SamyFrancelet/LoRaSnow/README.md

# LoRaSnow
LoRaSnow est un projet de recherche, avec pour but de mesurer la hauteur de neige sur une route, pendant qu'il neige.
