SamyFrancelet/LoRaSnow/0500_Software/readme

This folder contains all the files of the Computer/Raspberry programm
