SamyFrancelet/LoRaSnow/0600_Fab/0701_Board/readme

This folder contains all the file necessary to build the PCB
