SamyFrancelet/LoRaSnow/0600_Fab/0704_Software/readme

Binary / Installer for the computer/raspberry software
