SamyFrancelet/LoRaSnow/0000_Docs/0000_Report/LoRaSnow_report/LoRaSnow.tex

\documentclass[11pt,titlepage]{report}
\usepackage{Preamble}
\addbibresource{ref.bib}

\begin{document}

\begin{titlepage}
	\newgeometry{margin=3cm}
	\centering
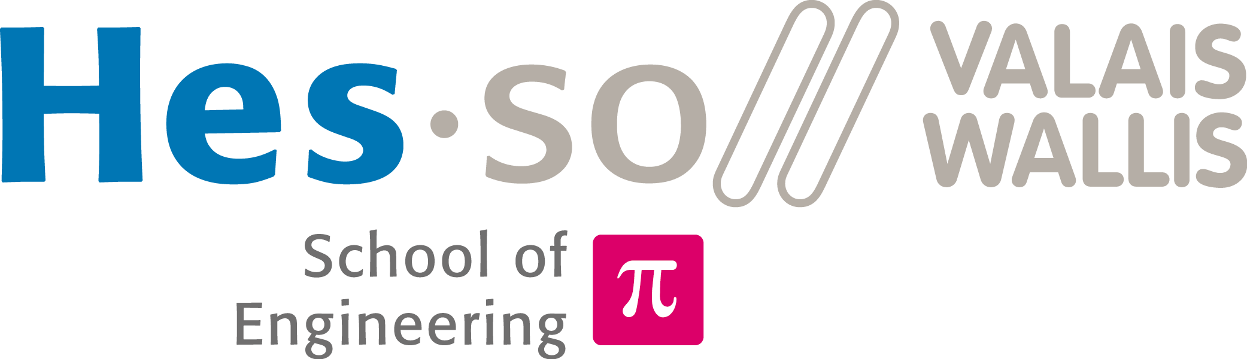
[picture p1: 0000_Docs/0000_Report/business_report/Images/hes/hei.png]
    \\[1cm] 	% University Logo
    \textsc{\LARGE Haute école d'ingénieur du Valais}\\ \vspace{\fill}
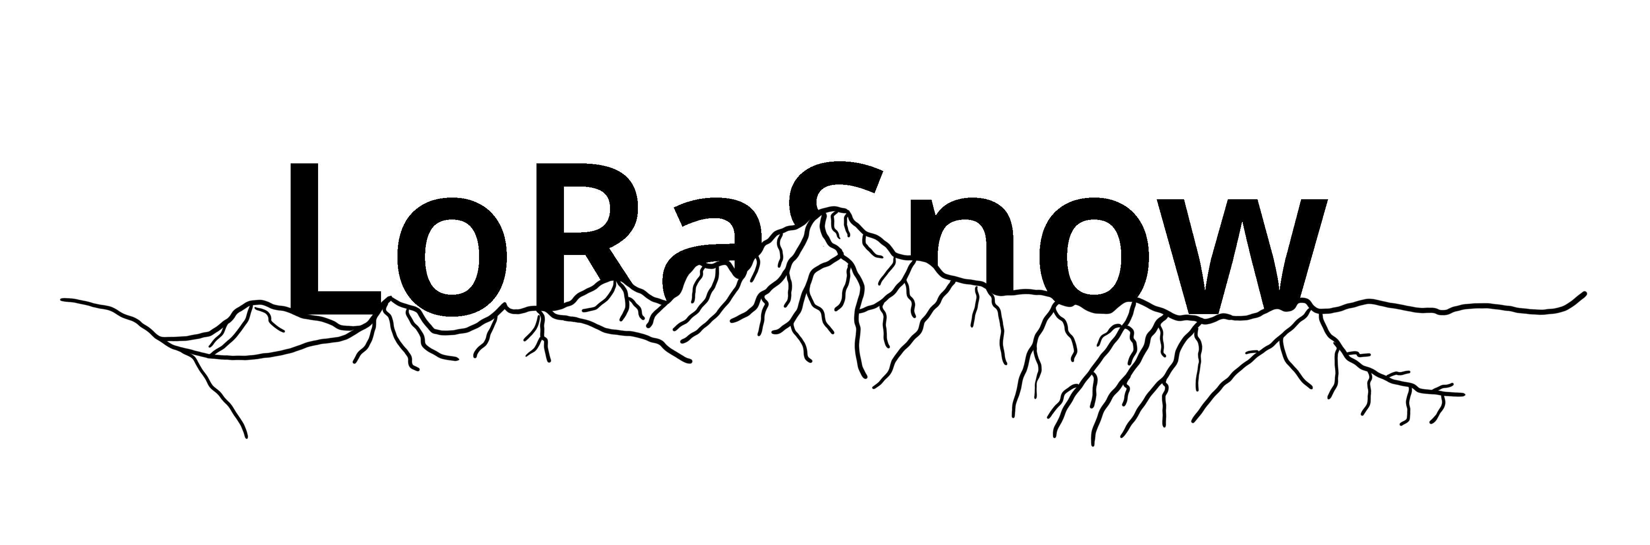
[picture p2: 0000_Docs/0000_Report/LoRaSnow_report/Images/Logo_LoRaSnow.png]
    \\ \vspace{\fill}
	%\textbf{\textsc{\fontsize{35}{35}\selectfont LoRaSnow}}\\ \vspace{\fill}
	\textsc{\LARGE Mesure du niveau de neige en conditions difficiles}\\[0.4cm]
	\rule{\linewidth}{0.2 mm} \\[0.5 cm]
	Samy Francelet, Vincent Savioz, Gabriel Deferr \\
	\today
\end{titlepage}
\restoregeometry

\tableofcontents
\listoffigures
\listoftables
\pagestyle{fancy}

\chapter{Introduction}
\input{1-Introduction.tex}

\part{Technique}

\chapter{Spécifications}
\input{tech/2-Specs.tex}

\chapter{LiDAR}
\input{tech/LiDAR/methods.tex}
\input{tech/LiDAR/results.tex}

\chapter{Computer Vision}
\input{tech/ComputerVision/introduction.tex}
\input{tech/ComputerVision/methods.tex}
\input{tech/ComputerVision/results.tex}

\chapter{Mécanique}
\input{tech/mechanical/methods.tex}

\chapter{Synthèse des résultats}
\input{tech/6-Discussion.tex}

\part{Gestion}

\chapter{Résumé}
\input{business/7-Resume.tex}

\chapter{Produits et services}
\input{business/8-Produits.tex}

\chapter{Marché et Contexte}
\input{business/9-Contexte.tex}

\chapter{Stratégie}
\input{business/10-Strategie.tex}

\chapter{Mesures}
\input{business/11-Mesures.tex}

\chapter{Finances}
\input{business/12-Finances.tex}

\chapter{Conclusion}
\input{13-Conclusion.tex}

\appendix

\chapter{Planning}
\label{app:planning}
\section{Planning prévisionnel}
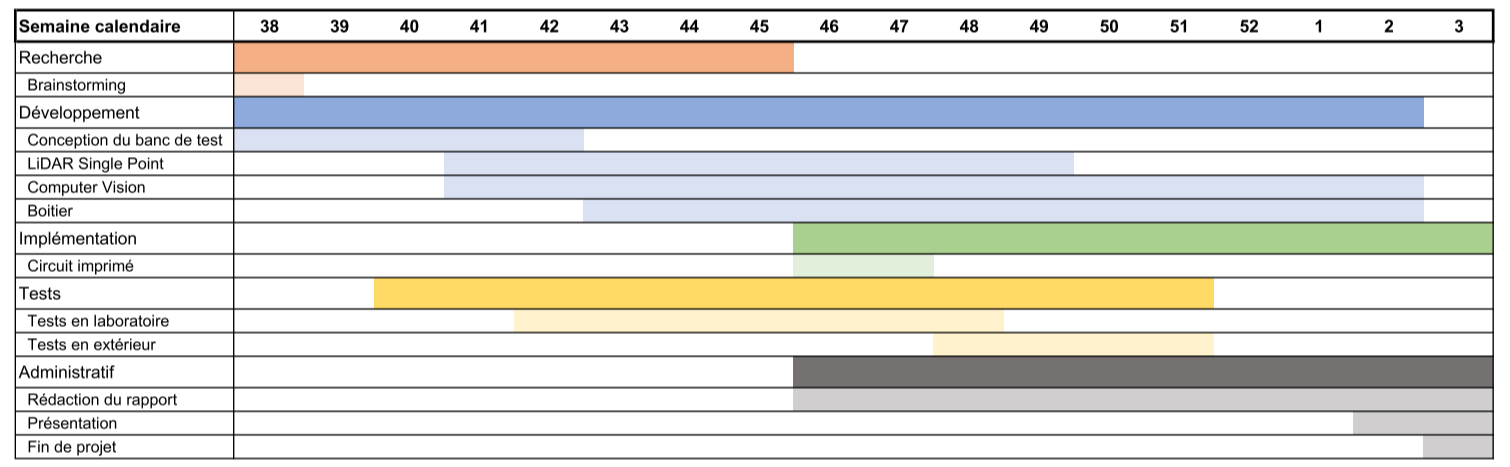
[picture p3: 0000_Docs/0000_Report/LoRaSnow_report/Images/business/planning/prevu.PNG]

\section{Planning réalisé}
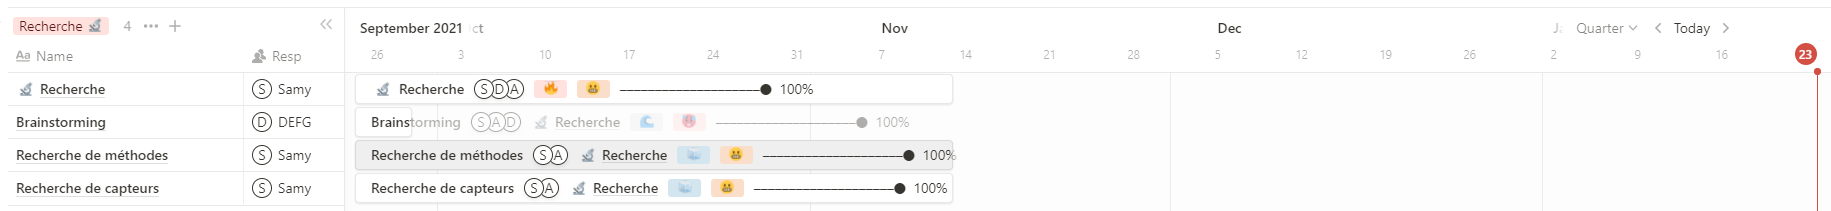
[picture p4: 0000_Docs/0000_Report/LoRaSnow_report/Images/business/planning/research.PNG]

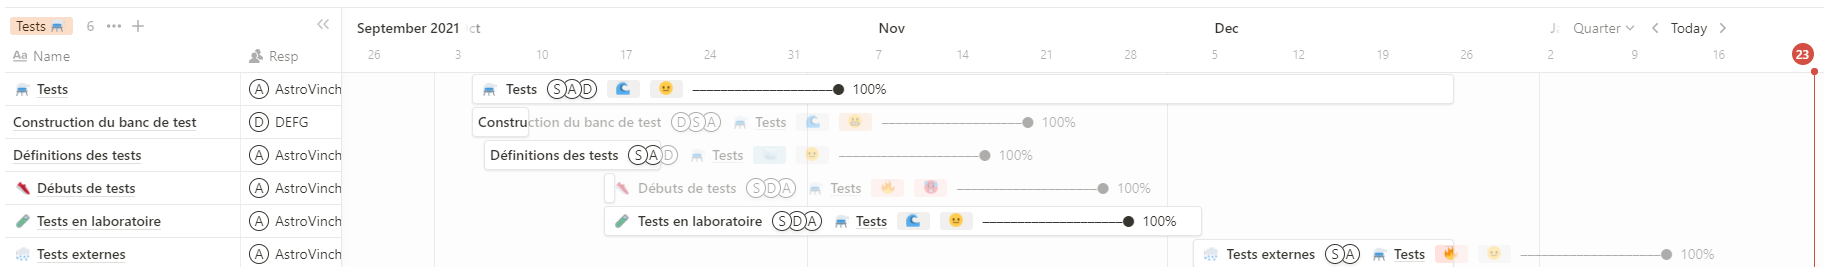
[picture p5: 0000_Docs/0000_Report/LoRaSnow_report/Images/business/planning/tests.PNG]

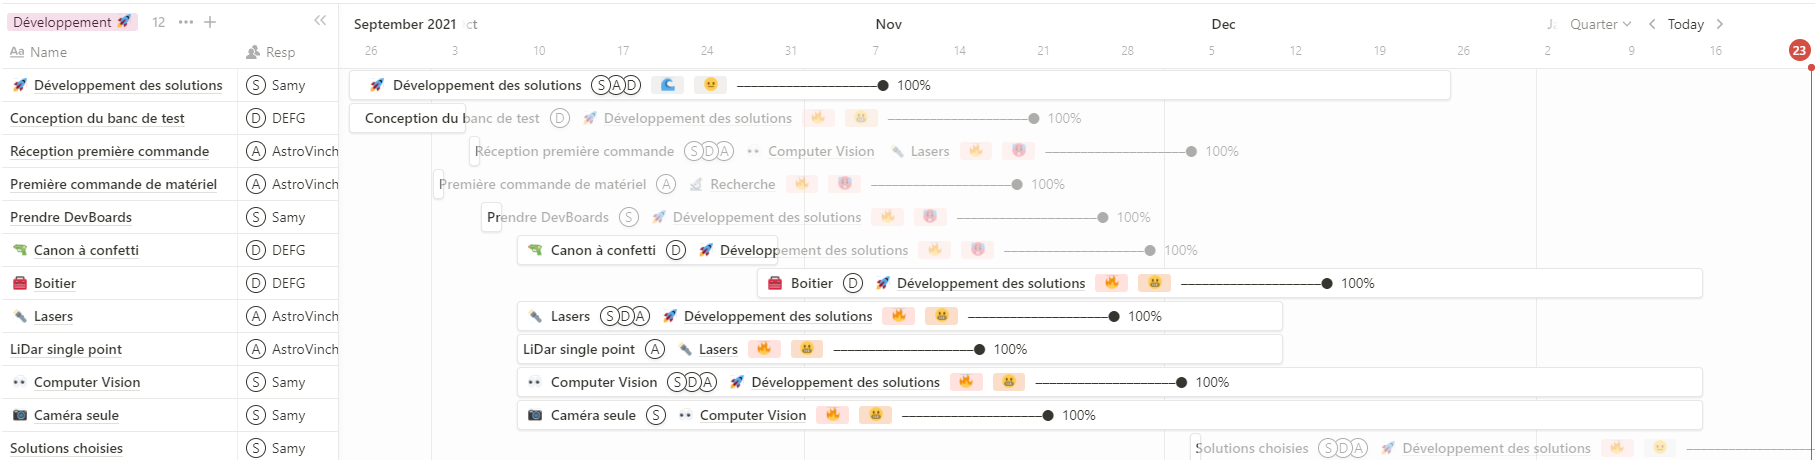
[picture p6: 0000_Docs/0000_Report/LoRaSnow_report/Images/business/planning/dev.PNG]
\newpage
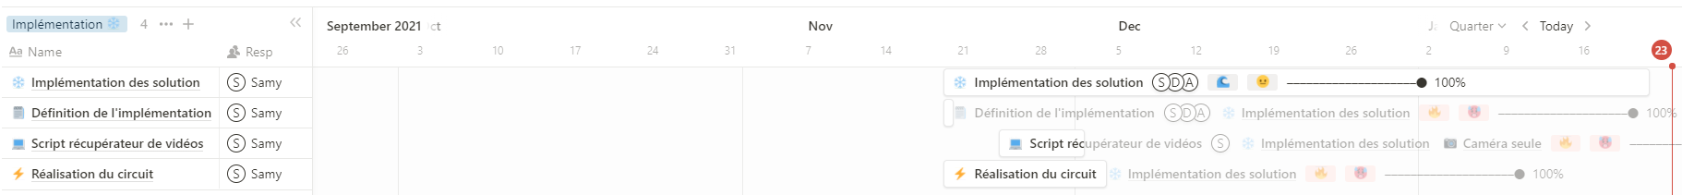
[picture p7: 0000_Docs/0000_Report/LoRaSnow_report/Images/business/planning/implementation.PNG]

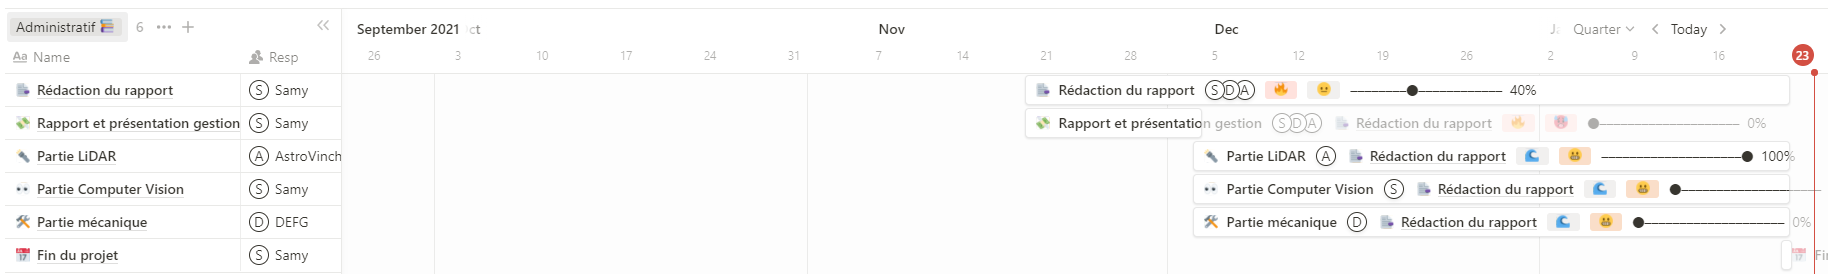
[picture p8: 0000_Docs/0000_Report/LoRaSnow_report/Images/business/planning/admin.PNG]


\chapter{Bilan prévisionnel}
\label{app:bilan}
\section{Prix et coûts}
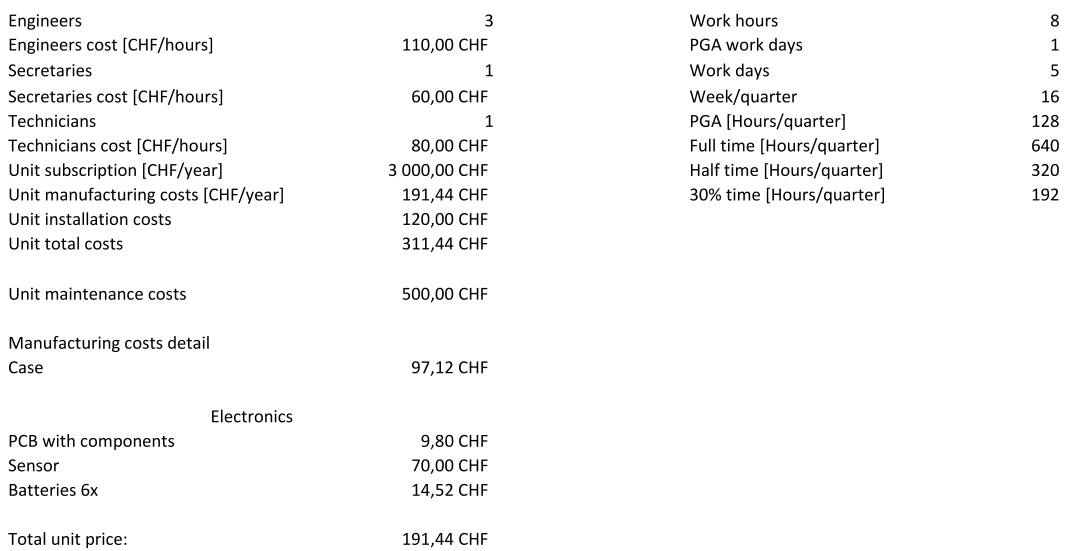
[picture p9: 0000_Docs/0000_Report/LoRaSnow_report/Images/business/costs.png]
 \\[1cm]
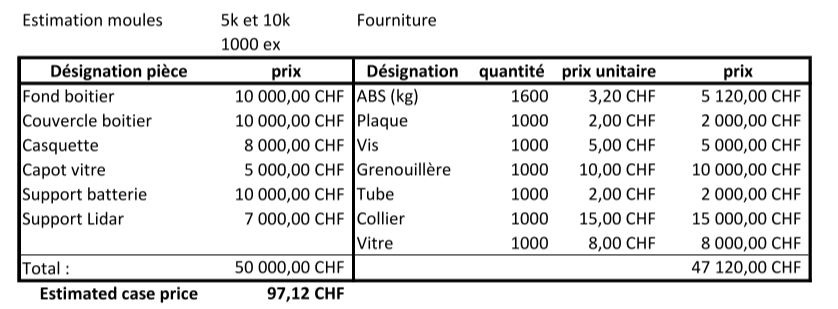
[picture p10: 0000_Docs/0000_Report/LoRaSnow_report/Images/business/case_price.PNG]

\newpage
\section{Budgets et bilans}
\subsection{Base case}
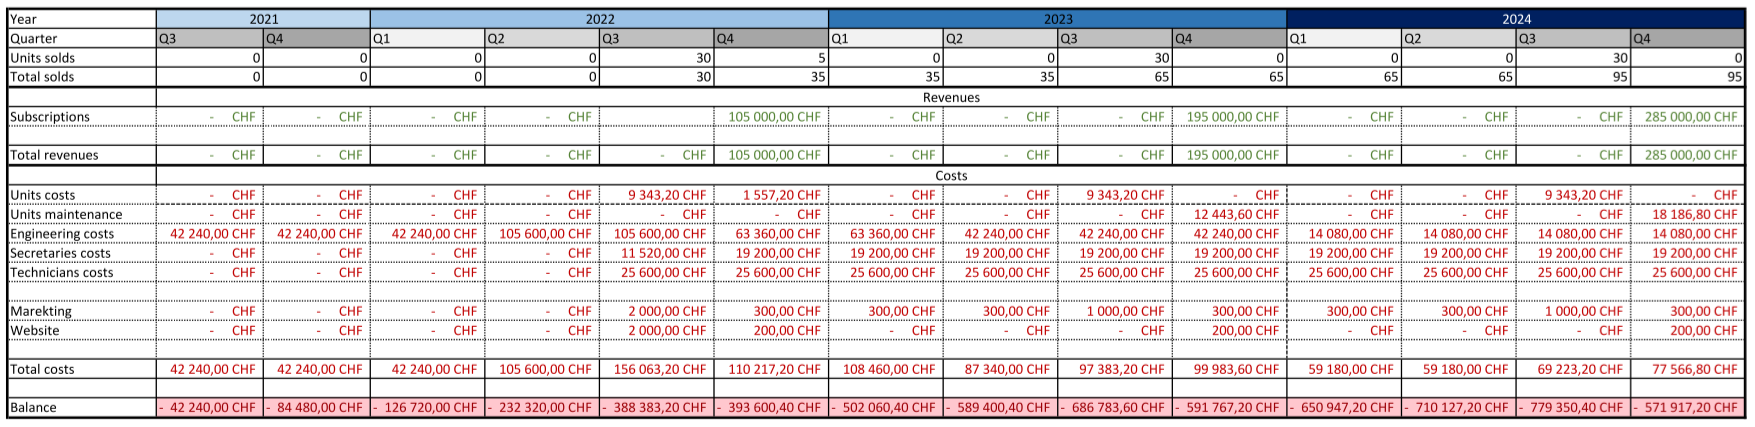
[picture p11: 0000_Docs/0000_Report/LoRaSnow_report/Images/business/base.PNG]

\subsection{Worst case}
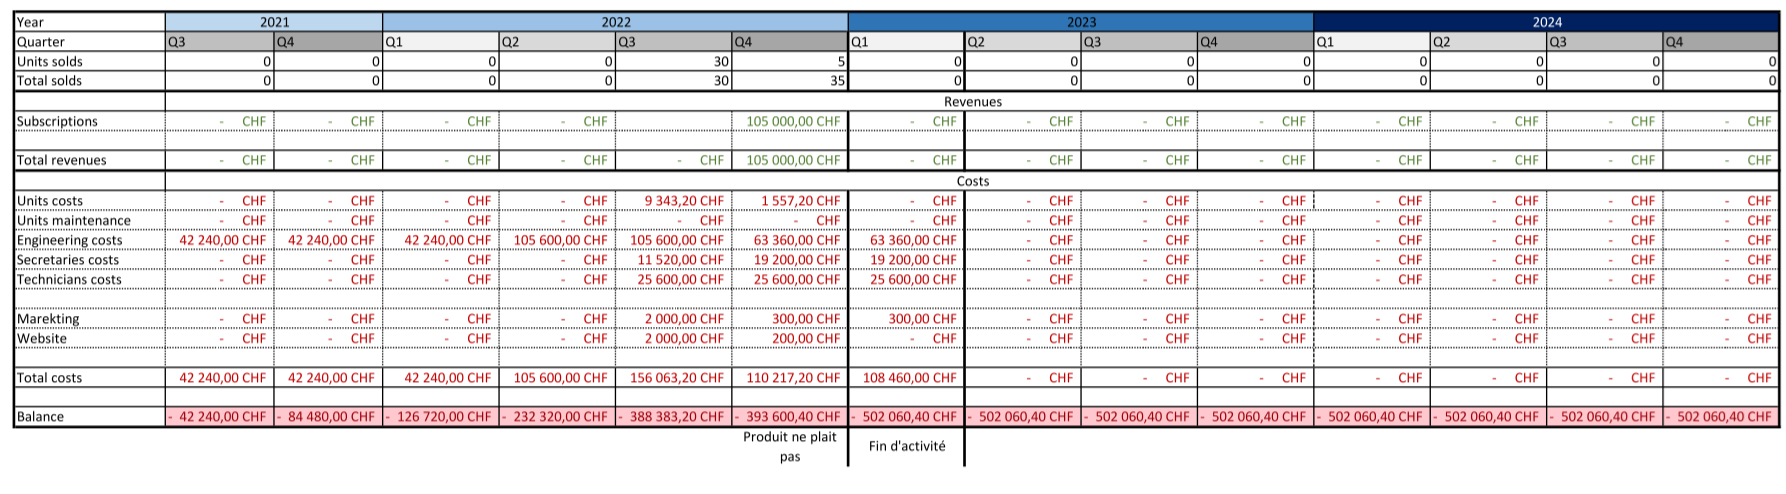
[picture p12: 0000_Docs/0000_Report/LoRaSnow_report/Images/business/worst.PNG]

\subsection{Best case}
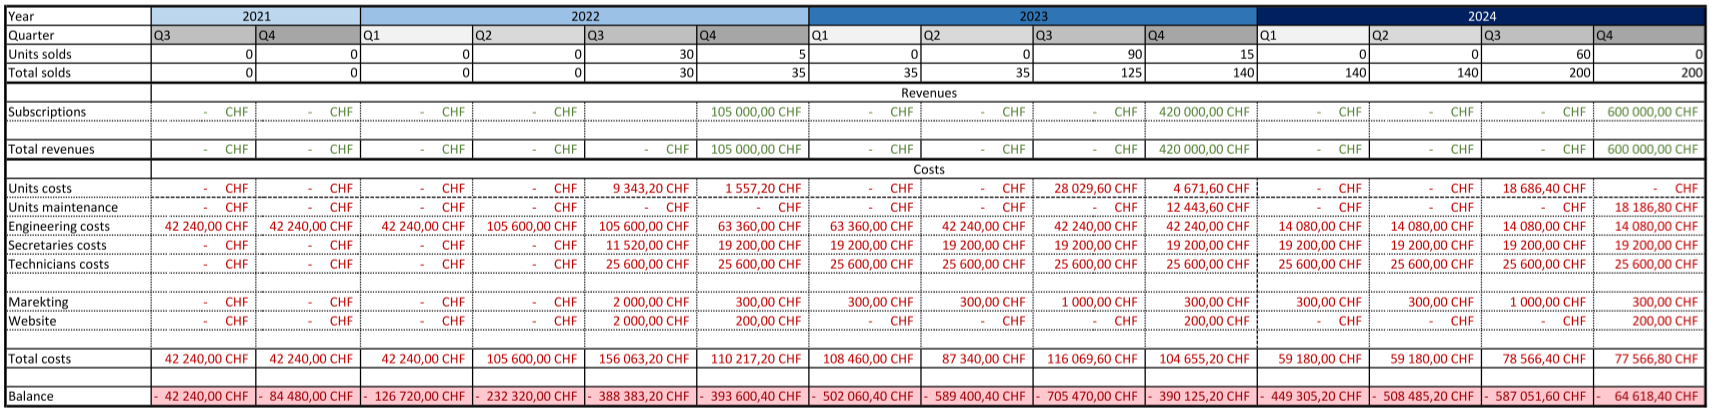
[picture p13: 0000_Docs/0000_Report/LoRaSnow_report/Images/business/best.PNG]


\chapter{Schéma électronique}
\includepdf[pages=1, angle=90]{Docs/schema}

\chapter{Mises en plan}
\includepdf[pages=-, angle=90]{Docs/misesenplansmergez}

\chapter{Protocoles de test du LiDAR}
\label{app:testLiDAR}
\includepdf[pages=-, angle=90]{Docs/poiuztrewq}

\setlength{\topmargin}{-2.2mm} % = 0mm -1in + 23.2mm
\printbibliography[heading=bibintoc]

\end{document}
