SamyFrancelet/LoRaSnow/0000_Docs/0000_Report/report_LiDARPart/report_LiDAR.tex

\documentclass[11pt,titlepage]{report}
\usepackage{Preamble}
%\addbibresource{ref.bib}

\begin{document}

\begin{titlepage}
	\newgeometry{margin=3cm}
	\centering
    \\[1cm] 	% University Logo
    \textsc{\LARGE Haute école d'ingénieur du Valais}\\ \vspace{\fill}
    \textbf{\textsc{\fontsize{35}{35}\selectfont Report Name}}\\ \vspace{\fill}
	\textsc{\LARGE Course name}\\[0.4cm]
	\rule{\linewidth}{0.2 mm} \\[0.5 cm]
	Author Name \\
	\today
\end{titlepage}
\restoregeometry

\tableofcontents

\chapter{Introduction}
\input{1-Introduction}

\chapter{Spécifications}
\input{2-Specs}

\chapter{LiDAR}
\input{3-MethodsLiDAR}
\input{4-ResultsLiDAR}

\chapter{Synthèse}
\input{5-Analyse-LiDAR.tex}

\chapter{Conclusion}
\input{6-Conclusion}

\end{document}
