SamyFrancelet/LoRaSnow/0000_Docs/0000_Report/computer_vision/LoRaSnow.tex

\documentclass[11pt,titlepage]{report}
\usepackage{Preamble}
\addbibresource{ref.bib}

\begin{document}

\begin{titlepage}
	\newgeometry{margin=3cm}
	\centering
    \\[1cm] 	% University Logo
    \textsc{\LARGE Haute école d'ingénieur du Valais}\\ \vspace{\fill}
    \textbf{\textsc{\fontsize{35}{35}\selectfont LoRaSnow}}\\ \vspace{\fill}
	\textsc{\LARGE PGA}\\[0.4cm]
	\rule{\linewidth}{0.2 mm} \\[0.5 cm]
	Samy Francelet \\
	\today
\end{titlepage}
\restoregeometry

\tableofcontents

\chapter{Computer Vision}
\input{ComputerVision.tex}

\printbibliography[heading=bibintoc]

\end{document}
