SamyFrancelet/LoRaSnow/0200_Hardware/LoRaSnow_shield/LoRaSnow.PcbDoc.htm

Reporting Options

# File in Previous Format

Date | : | 26.11.2021
Time | : | 10:31:46
Filename | : | C:\Users\vincent.savioz\Desktop\LoRaSnow_board\LoRaSnow.PcbDoc

Version | Warning

This file was generated by an earlier version of the software
