SamyFrancelet/LoRaSnow/0000_Docs/0004_Business/planning_prevu.pdf

Semaine calendaire | 38 39 40 41 42 43 44 45 46 47 48 49 50 51 52 1 2 3
Recherche
Brainstorming
Développement
Conception du banc de test LiDAR Single Point
Computer Vision
Boitier
Implémentation
Circuit imprimé
Tests
Tests en laboratoire
Tests en extérieur
Administratif
Rédaction du rapport
Présentation
Fin de projet
