SamyFrancelet/LoRaSnow/0000_Docs/0005_Report/Rentabilité.xlsx

 | Rentabilité pour la commune
 | Best case | Base case | Worst case
2022 | 0kCHF | 0kCHF | 0kCHF
2023 | -0.03kCHF | -0.01kCHF | -0.03kCHF
2024 | -0.025kCHF | -0.015kCHF | -0.025kCHF
2025 | -0.022kCHF | -0.02kCHF | -0.03kCHF
2026 | -0.016kCHF | -0.025kCHF | -0.025kCHF
2027 | -0.012kCHF | -0.035kCHF | -0.035kCHF
 | Rentabilité pour LoRaSnow
 | Best case | Base case | Worst case
2022 | -0.5kCHF | -0.5kCHF | -0.5kCHF
2023 | -0.5kCHF | -0.7kCHF | -0.7kCHF
2024 | -0.15kCHF | -0.5kCHF | -0.6kCHF
2025 | 0.2kCHF | -0.3kCHF | -0.5kCHF
2026 | 0.7kCHF | 0kCHF | -0.55kCHF
2027 | 1.5kCHF | 0.4kCHF | -0.6kCHF
