SamyFrancelet/LoRaSnow/0600_Fab/0702_Mechanical/readme

This folder contains all the files to make de mechanic of the project
