SamyFrancelet/LoRaSnow/0000_Docs/0000_Report/LoRaSnow_report/tech/2-Specs.tex

\section{Cahier des charges}

LoRaSnow est un projet destiné à détecter de la neige sur une route lorsque les conditions 
météorologiques sont difficiles. Ainsi le système doit pouvoir fournir des résultats fiables,
même sous une neige importante, dans le brouillard ou encore lors de vents forts.\\
Le but du projet est donc de créer un module capable de détecter de la neige par une quelconque méthode 
définie et transmettre des données sur un réseau LoRaWAN tout en implémentant une solution en 
\emph{Edge Computing}. Notre travail ici est d'étudier les différentes possibilités qui s'offrent à nous 
pour accomplir cette tâche.

\begin{figure}[H]
    \centering
    
    \caption[]{Conditions typiques de fonctionnement du projet\footnotemark[1]}
    \label{fig:ConditionDifficiles}
\end{figure}

\footnotetext[1]{Copyright: MediaPunch/Shutterstock}

\newpage

\subsection{LoRaWAN}
LoRaWAN (acronyme de \emph{long-range wide-area network}) est un réseau de communication radio spécifique
à l'internet des objets (IoT). Ce protocole est utilisé pour transmettre des données sur de grandes 
distances tout en permettant une consommation électrique très faible. La longue portée de son signal 
permet l'installation d'appareils dans des endroits isolés, sans nécessairement avoir accès au réseau 
électrique ou mobile.\\
La topologie de LoRaWAN est dite en étoile d'étoiles. En effet, comme le montre la figure \ref{fig:LoRaWANTopo},
le serveur d'application se trouve au centre, et les passerelles réparties sur un territoire donné 
communiquent avec les appareils installés.

\begin{figure}[H]
    \centering
    
    \caption[]{Topologie LoRaWAN\footnotemark[1]}
    \label{fig:LoRaWANTopo}
\end{figure}

\footnotetext[1]{Tiré de la page Wikipedia LoRaWAN}

\subsection{Edge Computing}

Comme le réseau LoRa utilisé permet une transmission de données bas débit, il est important d'économiser
le plus possible la bande passante. Pour cela, la méthode d'optimisation d'\emph{Edge Computing} est
privilégiée, rapprochant le traitement des données au plus proche des capteurs.\\
En pratique, dans ce projet, cela signifie que les données récoltées seront traitées directement sur 
le module LoRaSnow. Ainsi, uniquement les résultats des mesures seront envoyés dans le cloud.
\newpage

\subsection{Notre interprétation du cahier des charges}
Comme le cahier des charges donne un objectif à atteindre, nous avons jugé important de préciser les 
étapes à accomplir pour détecter de la neige sur une route.

\begin{description}
    \item[Mesure de hauteur de neige] \hfill \\ 
    Afin d'avoir une indication sur l'enneigement de la route, nous 
    avons trouvé utile d'avoir une information sur la hauteur de neige présente. Cela nous permet d'avoir 
    une vue globale d'une région grâce à un réseau de capteurs. Sur un vaste territoire comme certaines
    communes de montagne, l'enneigement peut être irrégulier. De cette manière, nous pouvons connaître 
    facilement l'état des routes dans des endroits isolés.
    \item[Reconnaissance du débit de neige et de l'état de la route] \hfill \\
    En plus des informations de hauteur de neige, nous avons couplé une solution de vision par ordinateur
    qui nous permet de récolter des mesures sur l'enneigement de la route ainsi que le débit actuel de
    flocons, dans l'objectif de faire des prévisions à court terme.\\
    Nous avons estimé qu'il était important de créer une redondance sur l'indication de l'état de la
    route. En effet, nous nous attendons à ce que la mesure physique de hauteur de neige ne soit pas 
    capable de donner des résultats pertinents pour les premiers millimètres. De plus, la mesure de
    hauteur de neige sera sûrement réalisée sur une toute petite zone ou un point.
    Si cette zone/point est mal déneigé, ou qu'un objet comme une pierre se place à cet endroit,
    la mesure sera faussée.
    \item[Fixation et protection du module] \hfill \\ 
    Comme le module LoRaSnow sera exposé aux aléas météorologiques de la montagne, un boitier étanche 
    et résistant doit être confectionné sur mesure. Il doit permettre de protéger totalement l'électronique de 
    l'humidité et d'autres types de perturbations, et doit offrir une fixation simple,
    fiable et règlable. La fixation de l'électronique devra être organisée pour permettre une
    installation ou maintenance simple.
\end{description}

L'avantage principal de ce cahier des charges explicite réside dans le fait qu'il est très facile pour
nous de séparer les tâches entre les collaborateurs du projet. Ainsi, chaque solution n'est que très 
peu couplée aux autres durant le prototypage.
\newpage

\section{Schéma bloc global}

\begin{figure}[H]
    \centering
    
    \caption{Schéma bloc global du projet}
    \label{fig:GlobalBlockDiagram}
\end{figure}

\begin{description}
    \item[\emph{Environment}] \hfill \\ 
    Ceci représente l'environnement mesuré, c'est-à-dire la route enneigée. Il est important de noter
    que les deux capteurs qui observent l'environnement le font de manière non-intrusive.
    \item[\emph{Height Measurement}] \hfill \\
    Ce capteur se charge de mesurer une hauteur de neige sur la route selon une méthode définie. Il 
    communique ses mesures directement à l'\emph{Embedded Electronic}. 
    \item[\emph{Camera}] \hfill \\
    Cette partie s'occupe de mesurer le débit de flocons et d'indiquer si le segment de route est enneigé.
    Elle permet aussi de certifier que la \emph{Height Measurement} est bien fiable.
    \item[\emph{Embedded Electronic}] \hfill \\
    L'électronique embarquée représente la partie central du projet. C'est ici que l'on retrouve le
    microcontrôleur qui traite les données reçues par les différents capteur et de transmettre les
    résultats. 
    \item[\emph{LoRa Transmission}] \hfill \\
     Le module de transmission LoRa reçoit les données du microcontrôleur et les envoie sur le réseau 
     LoRaWAN à l'aide d'une antenne à l'intérieur du boitier.
    \item[\emph{LoRa Gateway}] \hfill \\
    La passerelle LoRaWAN couvre une surface donnée dans laquelle se trouvent un ou plusieurs modules 
    LoRaSnow. Ainsi, les données transmises sont réceptionnées et retransmises sur un réseau IP. 
    \item[\emph{Cloud Server}] \hfill \\   
    Finalement, on retrouve un serveur dans le cloud se chargeant de la bonne réception des données 
    de tous les modules LoRaSnow d'un même groupe. Les données récoltées peuvent ainsi être mises en
    forme et utilisées pour indiquer par exemple la couverture neigeuse d'une région.
\end{description}

Les trois derniers points évoqués (\emph{LoRa Transmission, LoRa Gateway, Cloud Server}) 
n'ont pas encore été implémentés dans le projet.
