SamyFrancelet/LoRaSnow/0000_Docs/0000_Report/LoRaSnow_report/business/12-Finances.tex

\section{Planification des coûts}
Les coûts liés au projet sont les suivants :
\begin{itemize}
    \item Trois ingénieurs à 110[CHF/heure]
    \item Un secrétaire à 60[CHF/heure]
    \item Un technicien à 80[CHF/heure]
    \item Un coût unitaire de fabrication à 191,44CHF :
    \begin{itemize}
        \item Le circuit imprimé à 9.80CHF
        \item Les composants pour un total de 84,52CHF
        \item Un boîtier mécanique en plastique moulé à 97,12[CHF]
    \end{itemize}
    \item Des coûts de Marketing liés aux déplacements, à la publicité ciblée
    \item Des coûts liés au site web ainsi qu'aux serveurs d'acquisition
\end{itemize}

\section{Bilan prévisionnel}
Un bilan prévisionnel sur 3 ans a été réalisé par trimestre.
Dans le pire des cas où le projet serait un échec total,
une perte de 500'000[CHF] est prévue.
Dans un bon cas, en louant 100 unités à la fin de la 3e année,
et que le développement est complet, les coûts sont amortis. Une
rentabilité sur 5 ans est envisageable.
Le bilan prévisionnel détaillé est disponible en annexe\ref{app:bilan}.

\section{Plan de liquidité}
Un somme de base de 675'000[CHF] est nécessaire pour industrialiser
entièrement la solution. Cette somme peut provenir d'un partenaire
éventuel ou d'un investisseur.
