SamyFrancelet/LoRaSnow/0000_Docs/0000_Report/LoRaSnow_report/business/8-Produits.tex

\section{Description du produit}
LoRaSnow est un projet pilote de détection de hauteur de neige sur route, de débit
de chute de neige ainsi que des risques de verglas.
L'objectif est de fournir une solution de montioring de l'état d'un segment de route.
Implémenter un réseau de modules LoRaSnow permettrait donc de surveiller une région entière et d'offrir
une meilleure gestion des ressources lors de la période hivernale, tant bien pour une administration
publique que pour une entreprise privée.\\
LoRaSnow utilise le protocole LoRaWAN pour communiquer les données sur le cloud, permettant ainsi
d'être installé n'importe où sans nécessiter d'infrastructure (internet ou électricité) au préalable.\\
Lorsque la neige commence à tomber, ou qu'une couche importante de neige est présente
sur une route, une alerte est transmise au client, lui ofrrant la possibilité d'être informé de la situation
sans devoir être actif devant un terminal. Cela permettrait d'éliminer les besoins de personnel
de piquet durant la nuit.

\section{Détection de hauteur de neige}
En utilisant un mélange de solutions lasers et de vision par ordinateur,
LoRaSnow permet une détection innovante et efficace de la couche de neige
présente sur un segment de route.

\section{Mesure du débit de chute de neige}
Toujours en utilisant la vision par ordinateur, une indication correcte et fiable
du débit de chute de neige en temps réel donne des informations sur les chutes de neige
sur la région, minimisant les risques de surprises.

\section{Détection du givre}
En intégrant une mesure de l'humidité ainsi qu'une mesure de la température
du bitume, couplé aux prévisions météos, LoRaSnow offre une prévision
de verglas efficace.

\section{Pourquoi nous ?}
Nous apportons une solution simple et autonome à un problème complexe et inexploré,
problème sur lequel nos prédécesseurs n'ont pas trouvé de solution fonctionnelle.
