SamyFrancelet/LoRaSnow/0100_Research/0120_Prototypes/0122_LiDarLitev4/2_TemperatureStability/TempSpecs.txt

-15
-10
-5
0
5
10
15
20
25
30
35
40

Précision de température : +-1°C
