SamyFrancelet/LoRaSnow/0100_Research/0120_Prototypes/Projet LoRaSnow Warning.docx

❄️Projet LoRaSnow❄️

⚠️NE PAS TOUCHER⚠️

👨‍👨‍👦 Samy Francelet, Gabriel Deferr et Vincent Savioz 👨‍👨‍👦

En cas de problème : 📱 078/906.38.28
