SamyFrancelet/LoRaSnow/0000_Docs/0004_Business/Risiko.pdf

Insignifant Réduite Percéptible Critique Très critique

| Très probable | Surpoids de neige sur l'appareil | Gravité / Effet Probabilité | | | | Risque non acceptable, des dispositions d'urgence sont nécessaires pour le réduire
| Possible | | | | | Pénurie de semi-conducteurs | Risque élevé, dispositions nécessaires pour le réduire
| Rare | | | | Vandalisme | Perte de la couverture LoRaWAN | Risque moyen, vérifier la nécessité de dispositions nécessaires pour le réduire
| Très rare | | | Températures extrêmes | | | Risque réduit, pas de dispositions nécessaires
Improbable | | Foudre | | Attaqué par la faune

# Analyse des risques
