SamyFrancelet/LoRaSnow/0000_Docs/0000_Report/LoRaSnow_report/Images/business/bilan.png

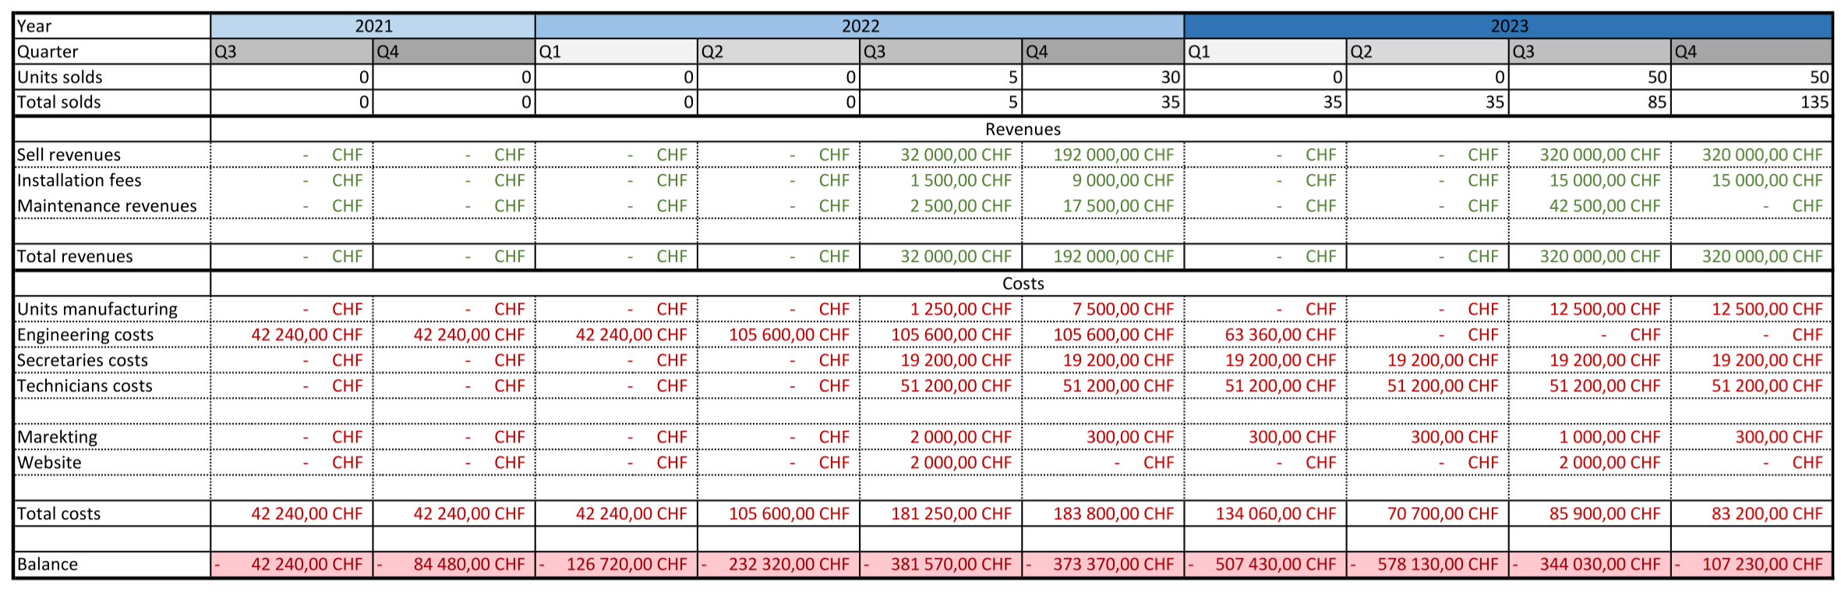
0000_Docs/0000_Report/LoRaSnow_report/Images/business/bilan.png
