SamyFrancelet/LoRaSnow/0000_Docs/0000_Report/LoRaSnow_report/Images/business/boschung.jpg

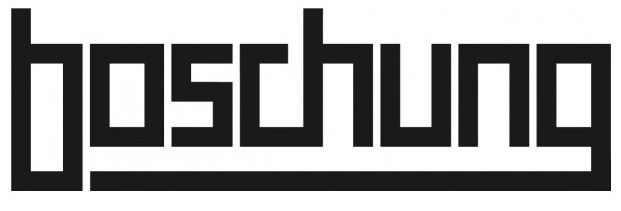
0000_Docs/0000_Report/LoRaSnow_report/Images/business/boschung.jpg
