SamyFrancelet/LoRaSnow/0000_Docs/0000_Report/LoRaSnow_report/Images/LiDAR/LiDAR_ErrorMes_Noise3.png

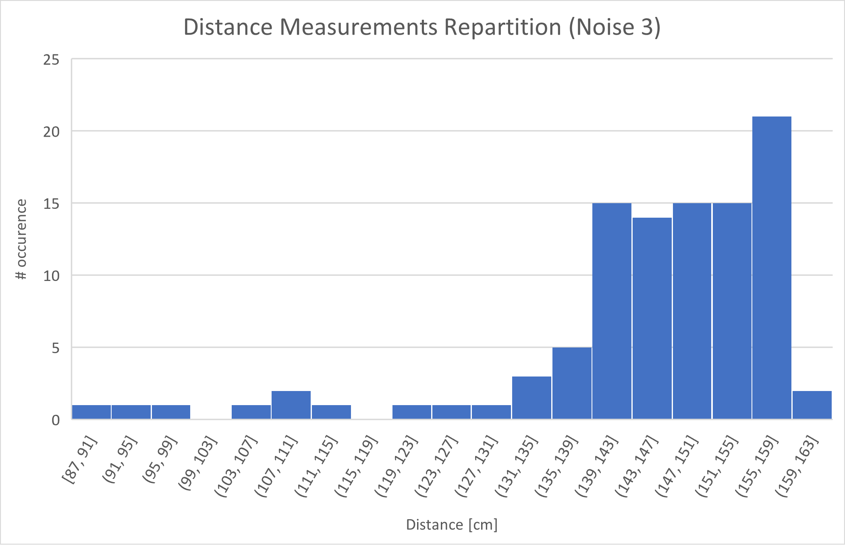
0000_Docs/0000_Report/LoRaSnow_report/Images/LiDAR/LiDAR_ErrorMes_Noise3.png
