SamyFrancelet/LoRaSnow/0000_Docs/0000_Report/LoRaSnow_report/Images/LiDAR/LiDAR_OffsetMes_DistToGround.png

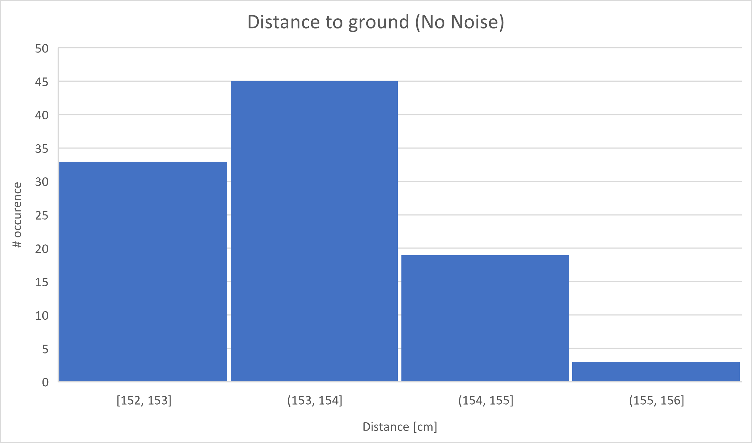
0000_Docs/0000_Report/LoRaSnow_report/Images/LiDAR/LiDAR_OffsetMes_DistToGround.png
