SamyFrancelet/LoRaSnow/0000_Docs/0000_Report/LoRaSnow_report/Images/LiDAR/OffsetMes_FromShelf.jpeg

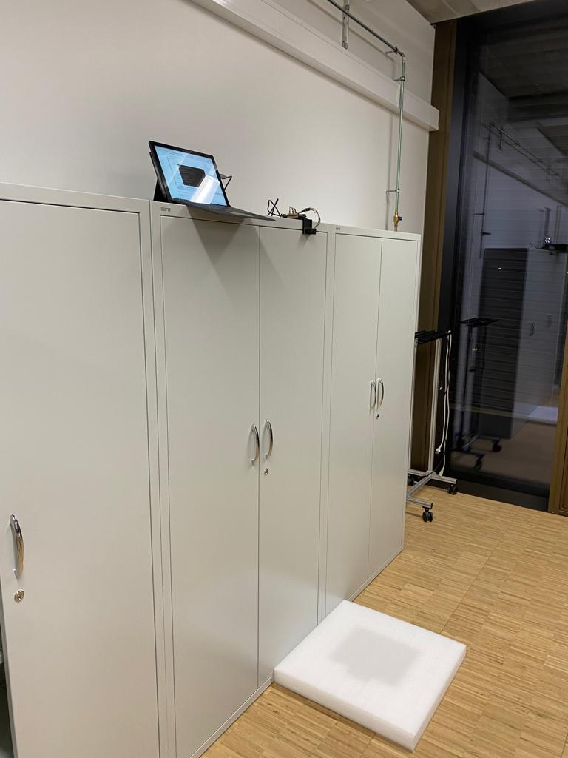
0000_Docs/0000_Report/LoRaSnow_report/Images/LiDAR/OffsetMes_FromShelf.jpeg
