SamyFrancelet/LoRaSnow/0000_Docs/0000_Report/LoRaSnow_report/Images/photos_PGA/boitierv4_vuecoupe.PNG

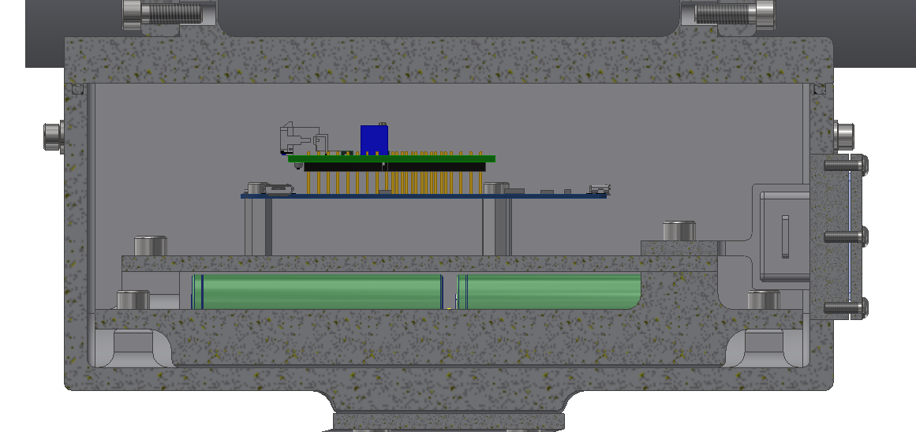
0000_Docs/0000_Report/LoRaSnow_report/Images/photos_PGA/boitierv4_vuecoupe.PNG
