SamyFrancelet/LoRaSnow/0000_Docs/0000_Report/LoRaSnow_report/Images/photos_PGA/canonComplpetv2.jpg

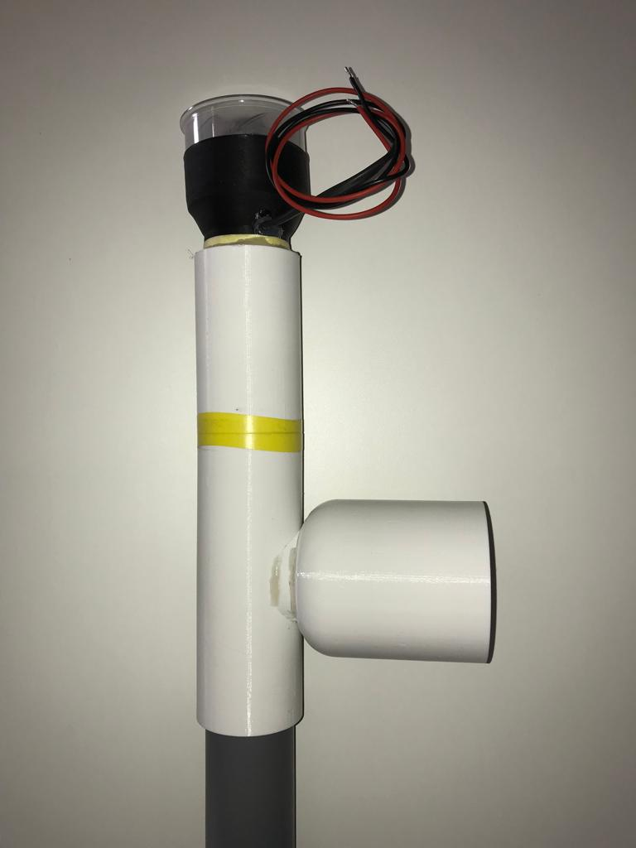
0000_Docs/0000_Report/LoRaSnow_report/Images/photos_PGA/canonComplpetv2.jpg
