SamyFrancelet/LoRaSnow/0000_Docs/0000_Report/LoRaSnow_report/Images/photos_PGA/E006_Boitier_v4_mur.png

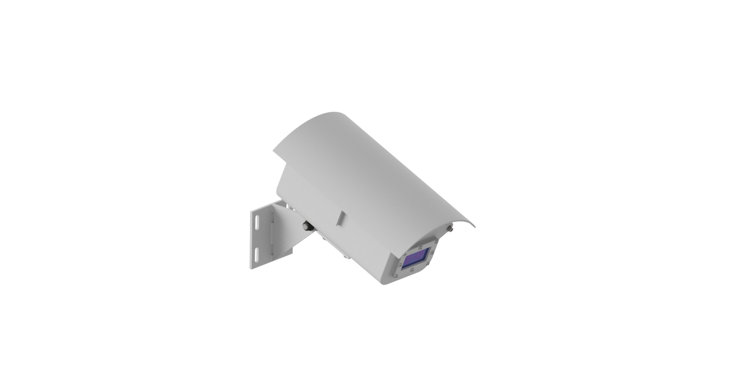
0000_Docs/0000_Report/LoRaSnow_report/Images/photos_PGA/E006_Boitier_v4_mur.png
