SamyFrancelet/LoRaSnow/0000_Docs/0000_Report/LoRaSnow_report/Images/photos_PGA/mécanique_vis.png

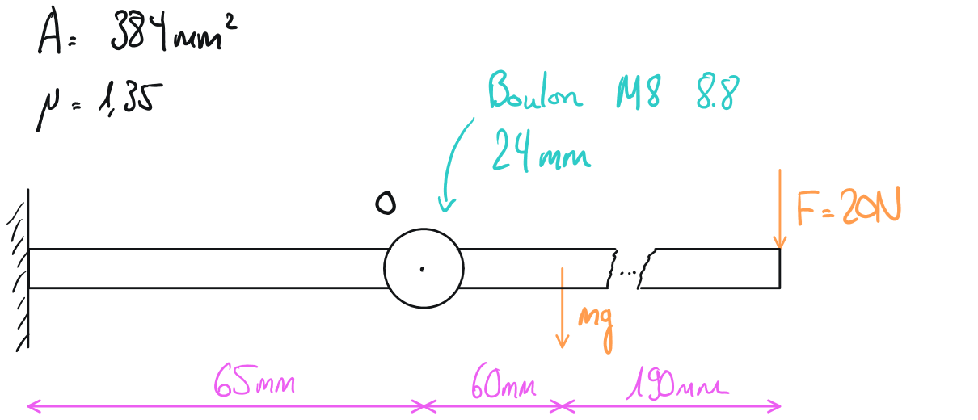
0000_Docs/0000_Report/LoRaSnow_report/Images/photos_PGA/mécanique_vis.png
