SamyFrancelet/LoRaSnow/0000_Docs/0000_Report/LoRaSnow_report/Images/photos_PGA/Protractor_Rapporteur_Degrees_V3.jpg

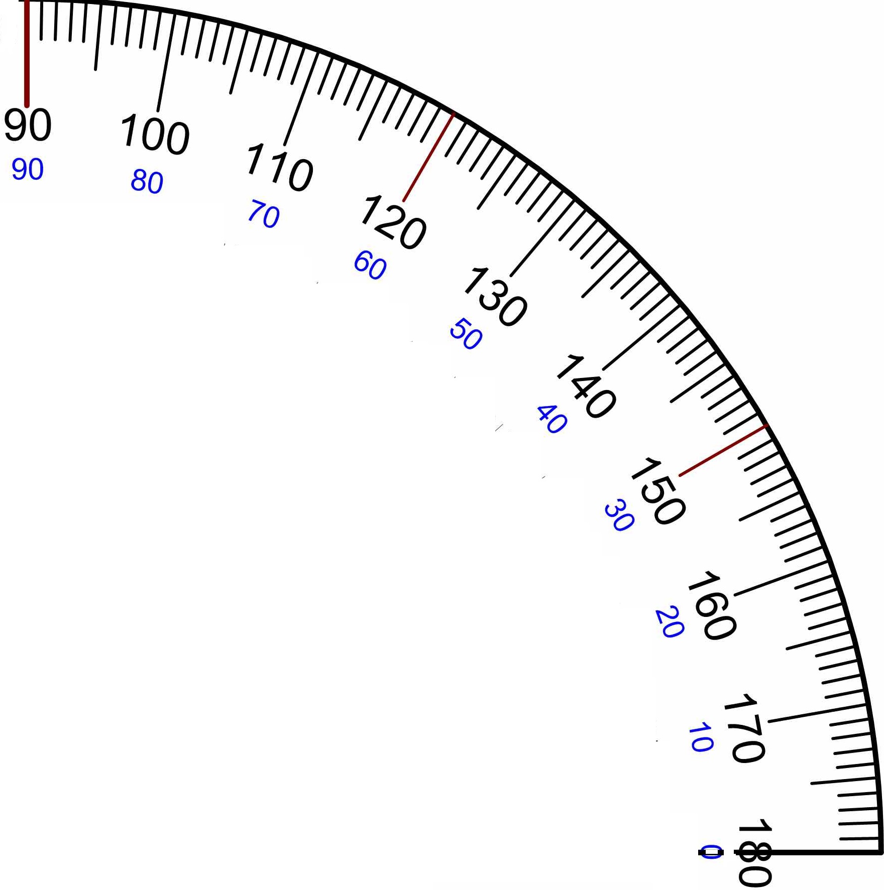
0000_Docs/0000_Report/LoRaSnow_report/Images/photos_PGA/Protractor_Rapporteur_Degrees_V3.jpg
