SamyFrancelet/LoRaSnow/0000_Docs/0000_Report/LoRaSnow_report/Images/photos_PGA/venturi.png

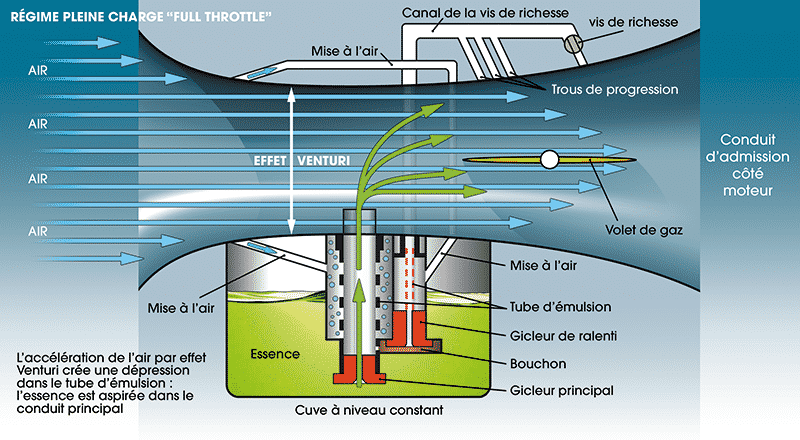
0000_Docs/0000_Report/LoRaSnow_report/Images/photos_PGA/venturi.png
