SamyFrancelet/LoRaSnow/0000_Docs/0000_Report/LoRaSnow_report/Images/photos_PGA/WhatsApp Image 2021-10-20 at 11.29.56.jpeg

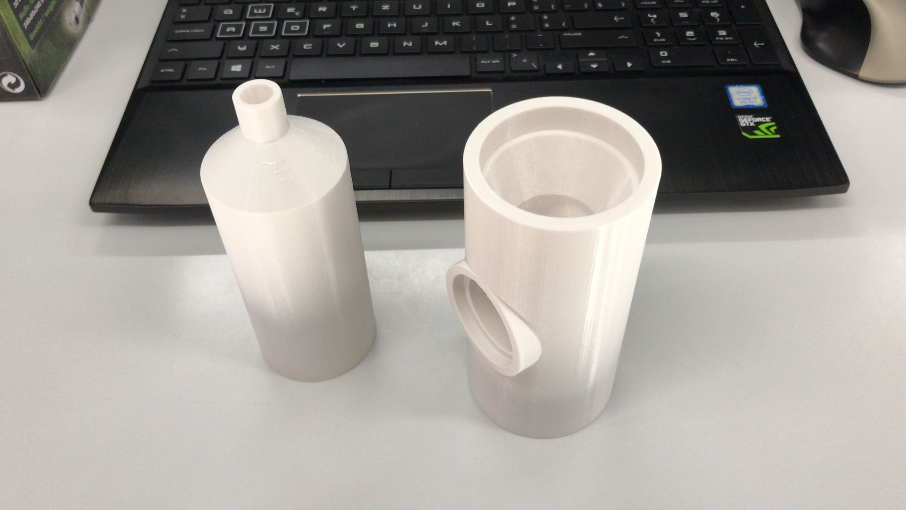
0000_Docs/0000_Report/LoRaSnow_report/Images/photos_PGA/WhatsApp Image 2021-10-20 at 11.29.56.jpeg
