SamyFrancelet/LoRaSnow/0000_Docs/0000_Report/LoRaSnow_report/Images/photos_PGA/WhatsApp Image 2022-01-16 at 17.44.20.jpeg

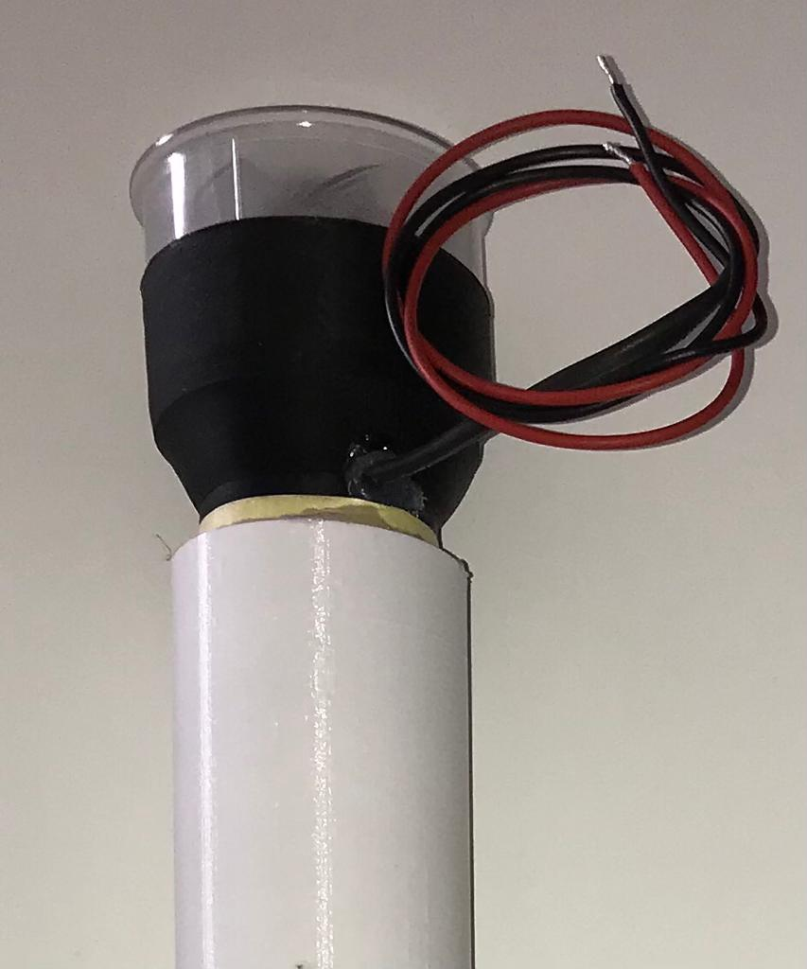
0000_Docs/0000_Report/LoRaSnow_report/Images/photos_PGA/WhatsApp Image 2022-01-16 at 17.44.20.jpeg
