SamyFrancelet/LoRaSnow/0000_Docs/0000_Report/LoRaSnow_report/Images/Signatures/Signature-Vincent.png

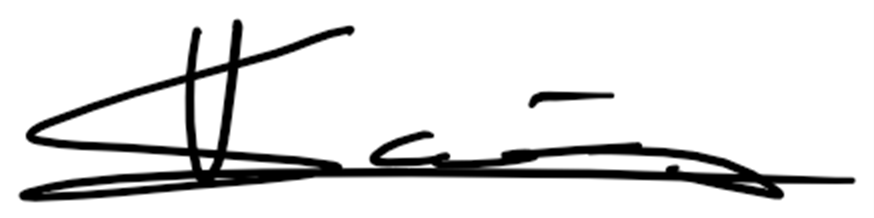
0000_Docs/0000_Report/LoRaSnow_report/Images/Signatures/Signature-Vincent.png
