SamyFrancelet/LoRaSnow/0000_Docs/0004_Business/Business-Model-Canvas-bilingue.webp

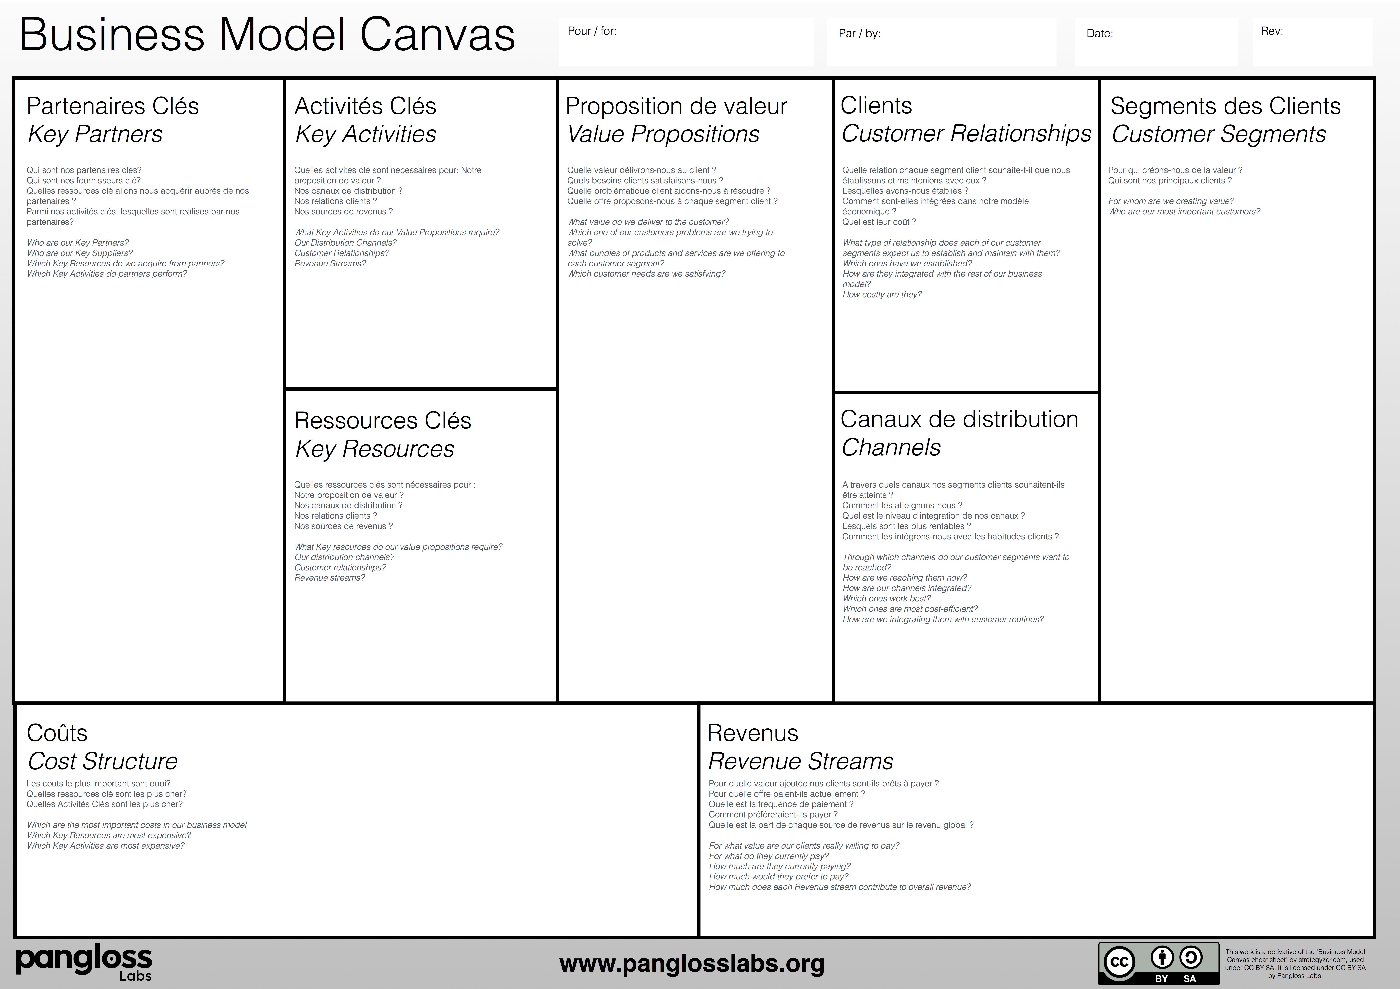
0000_Docs/0004_Business/Business-Model-Canvas-bilingue.webp
