SamyFrancelet/LoRaSnow/0000_Docs/0004_Business/business_model_canvas.png

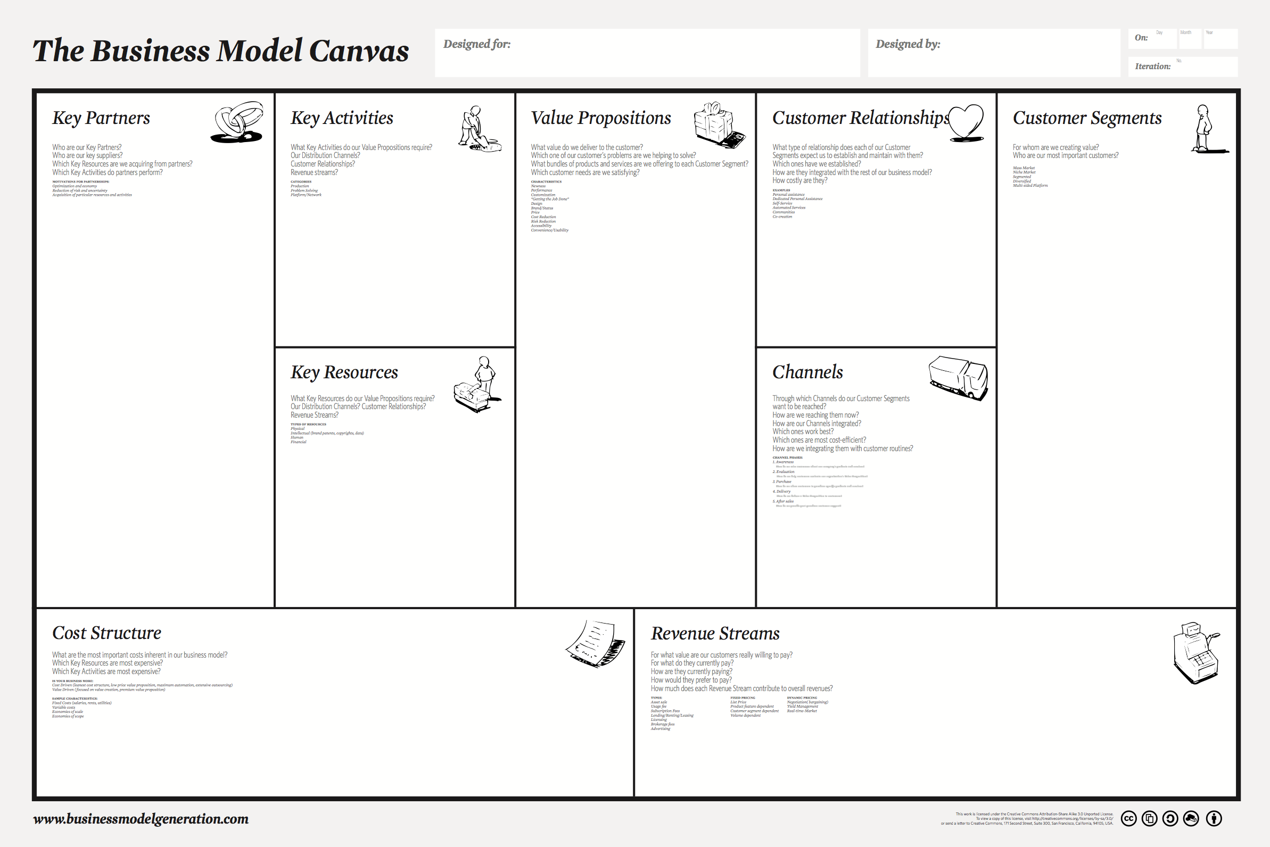
0000_Docs/0004_Business/business_model_canvas.png
