SamyFrancelet/LoRaSnow/0000_Docs/0004_Business/USP.png

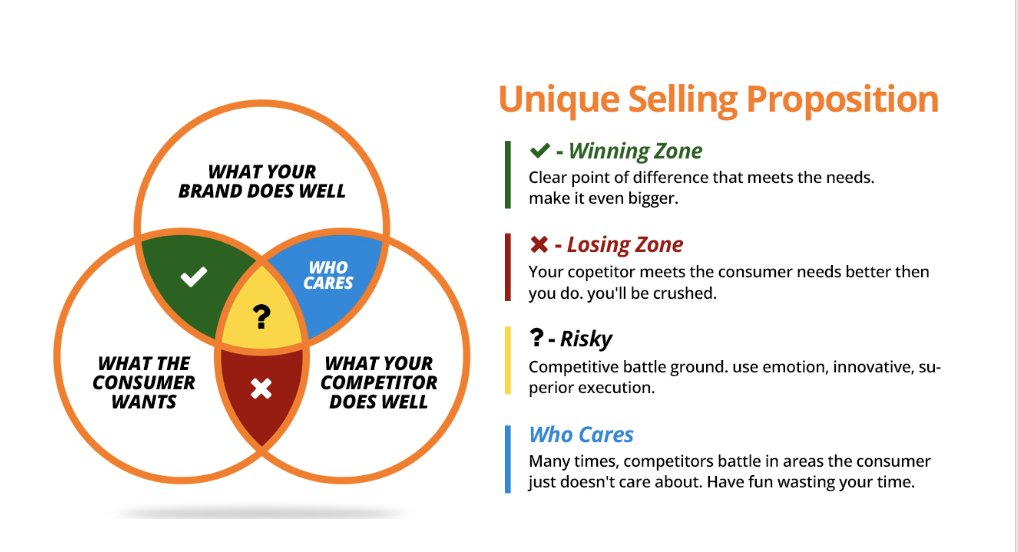
0000_Docs/0004_Business/USP.png
