SamyFrancelet/LoRaSnow/0000_Docs/0006_Branding/Black_T-Shirt.png

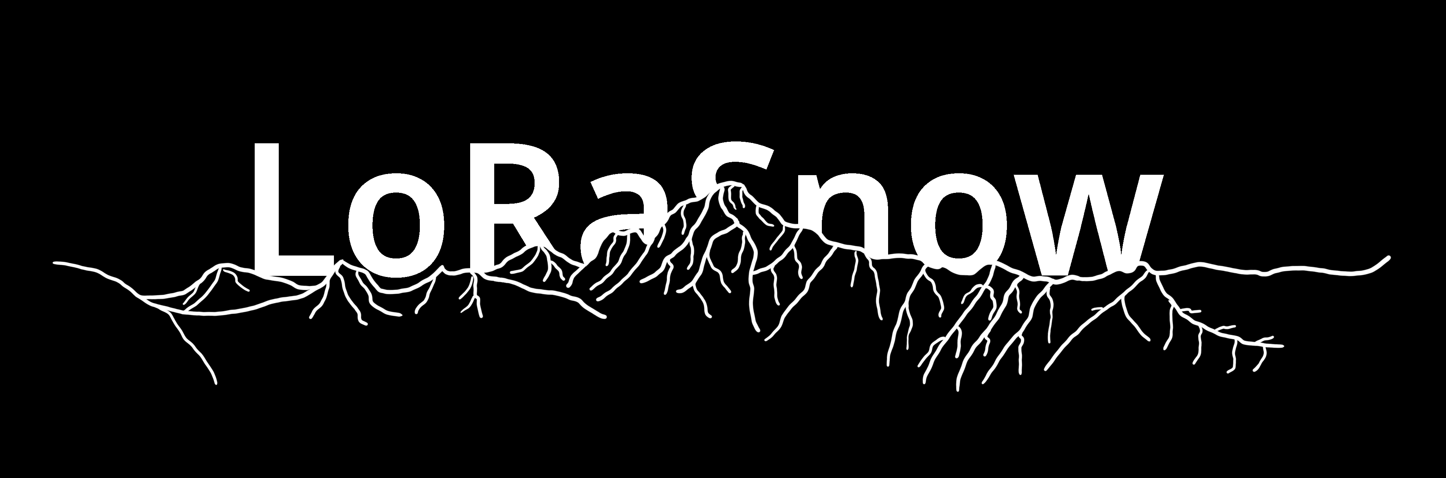
0000_Docs/0006_Branding/Black_T-Shirt.png
