SamyFrancelet/LoRaSnow/0000_Docs/0006_Branding/Cover.jpg

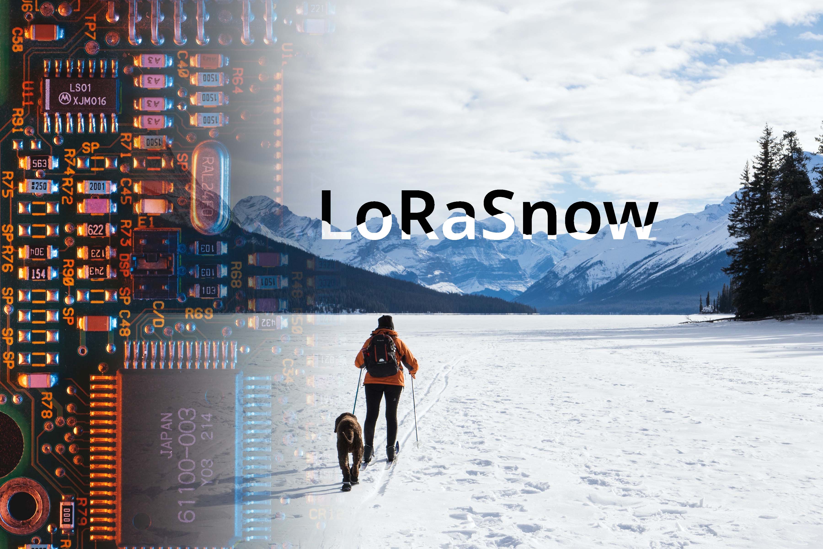
0000_Docs/0006_Branding/Cover.jpg
