SamyFrancelet/LoRaSnow/0000_Docs/0006_Branding/End.jpg

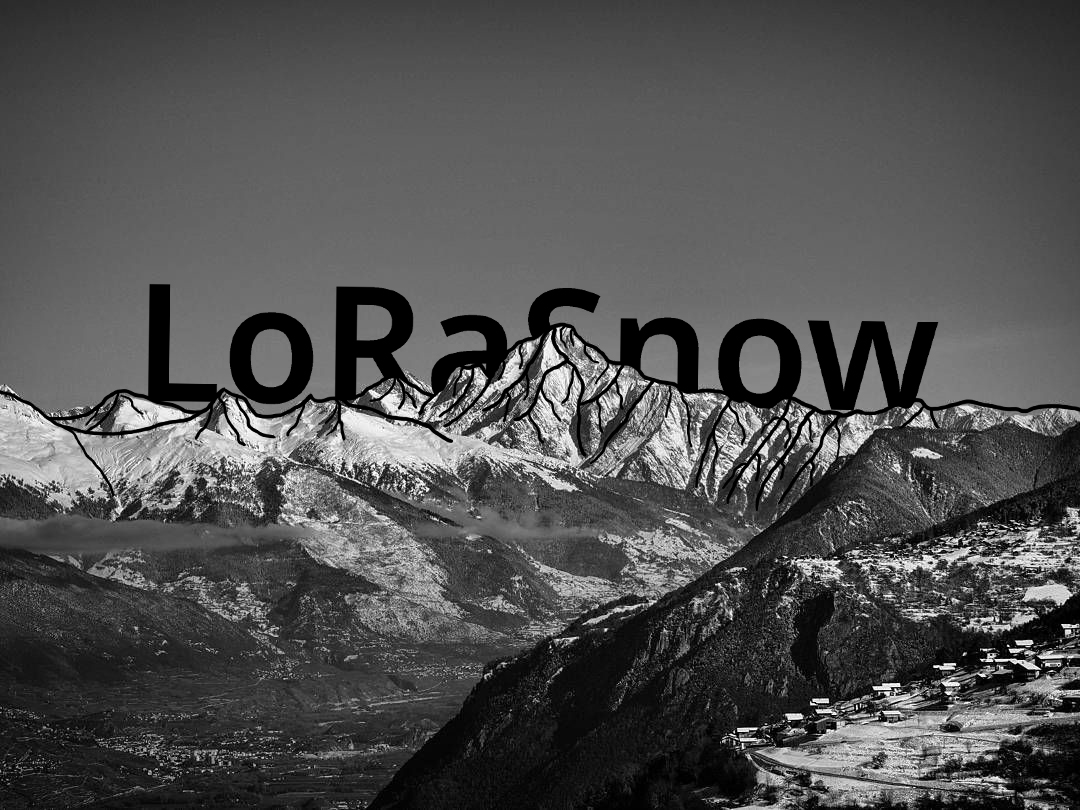
0000_Docs/0006_Branding/End.jpg
