SamyFrancelet/LoRaSnow/0200_Hardware/LoRaSnow_shield/Calculatos/NTC.PNG

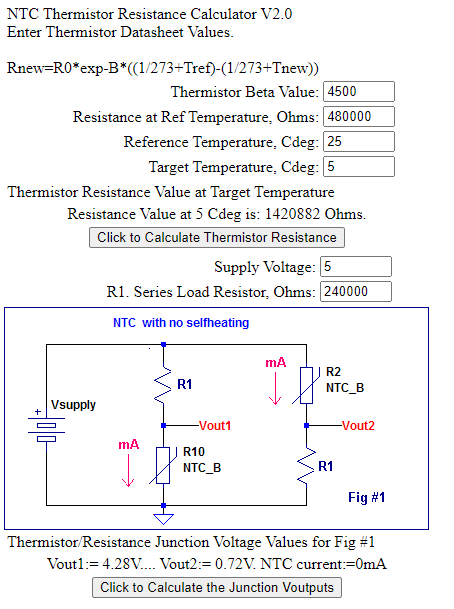
0200_Hardware/LoRaSnow_shield/Calculatos/NTC.PNG
