SamyFrancelet/LoRaSnow/0300_Mechanical/0310_Turbine/Motor_A2212.png

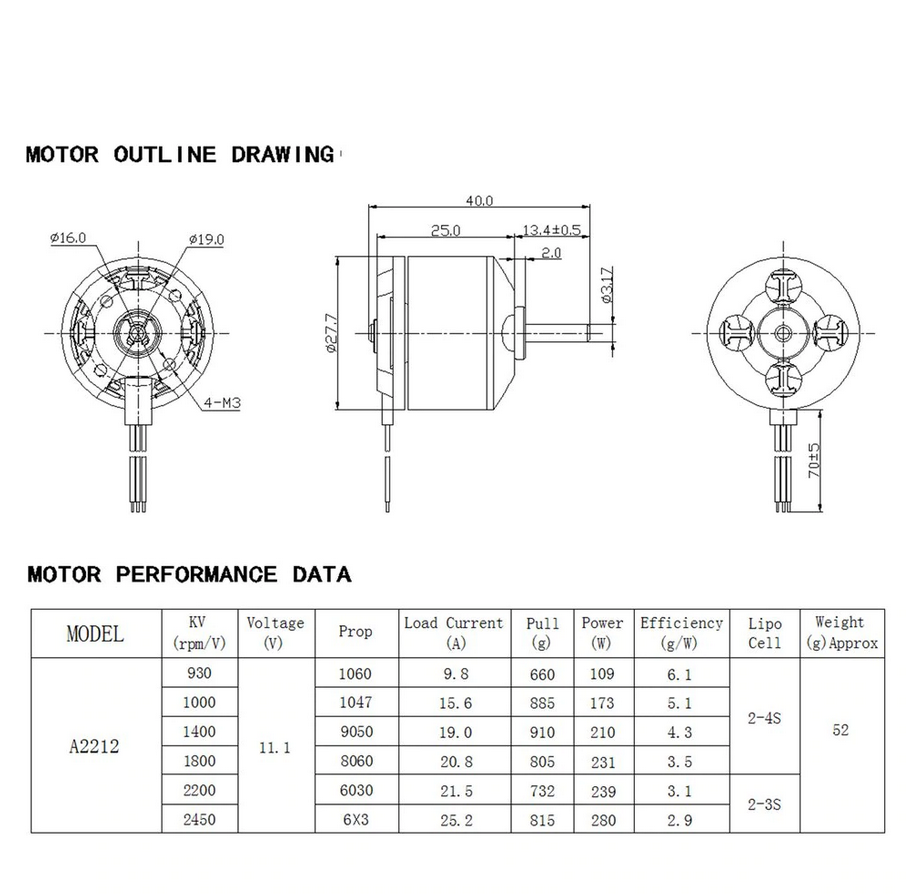
0300_Mechanical/0310_Turbine/Motor_A2212.png
