SamyFrancelet/LoRaSnow/0300_Mechanical/0310_Turbine/Propeller_6035.png

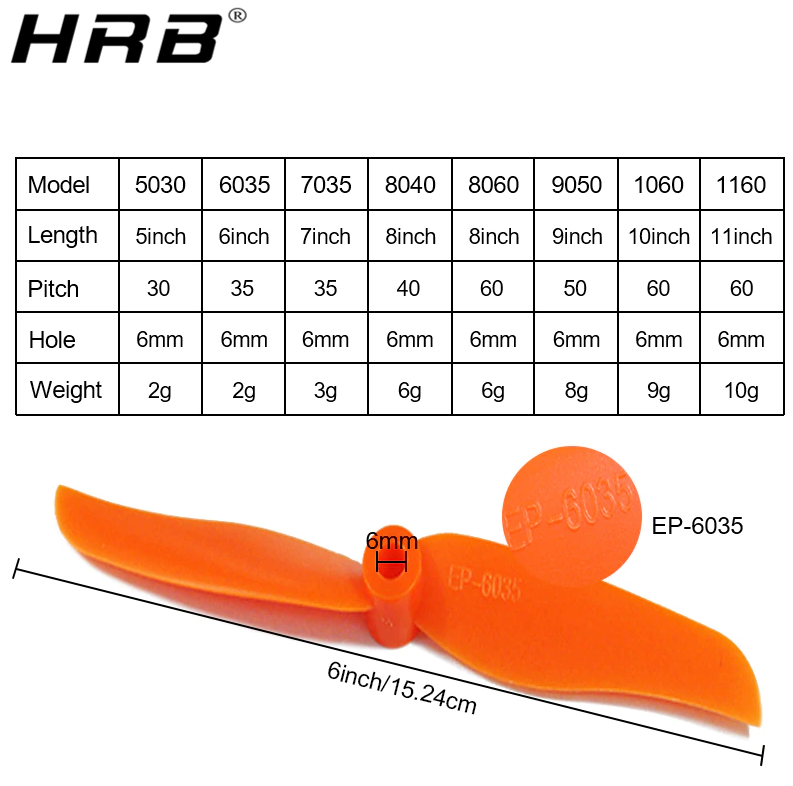
0300_Mechanical/0310_Turbine/Propeller_6035.png
