SamyFrancelet/LoRaSnow/0000_Docs/0003_Bill of materials/BoM.ods

Sheet: Bill of Material
Type | Part | Value | Package | Distributor | Unit | Qty | Description | art./isbn | Unit price | Total price | Comment
Capacitor
Resistor
uC

Sheet: List
Distributor
Distrelec
Farnell
Conrad
