SamyFrancelet/LoRaSnow/0000_Docs/0006_Branding/Commande_LoRaSnow_01.xls

Personne concernée: | Samy Francelet, Vincent Savioz, Gabriel Deferr
Mandat no.: | PGA | Chef de projet / professeur: | mui
Acronyme du projet: | LoRaSnow
Salle: | 23N322 | Délai désiré | 2021-10-08
Distrelec |  |  | Monnaie | CHF
Quantity | Reference | Designation | Unit Price
1 | 301-60-909 | VL53L1X Distance Sensor | 25.85 | 25.85
1 | 301-65-189 | Garmin LIDAR-Lite v4 | 84.33 | 84.33
2 | 302-21-924 | Unité de caméra Wi-Fi | 8.29 | 16.58
 |  |  |  | 0.00
 |  |  |  | 0.00
 |  |  |  | 0.00
 |  |  |  | 0.00
 |  |  |  | 0.00
 |  |  |  | 0.00
 |  |  |  | 0.00
 |  |  |  | 0.00
 |  |  |  | 0.00
 |  |  |  | 0.00
 |  |  |  | 0.00
 |  |  |  | 126.76
