SamyFrancelet/LoRaSnow/0000_Docs/0004_Business/Budget.xlsx

Sheet: Prices
Engineers | 3 | Work hours | 8 | Estimation moules | 5k et 10k | Fourniture
Engineers cost [CHF/hours] | 110.00 CHF | PGA work days | 1 |  | 1000 ex
Secretaries | 1 | Work days | 5 | Désignation pièce | prix | Désignation | quantité | prix unitaire | prix
Secretaries cost [CHF/hours] | 60.00 CHF | Week/quarter | 16 | Fond boitier | 10000.00 CHF | ABS (kg) | 1600 | 3.20 CHF | 5120.00 CHF
Technicians | 1 | PGA [Hours/quarter] | 128 | Couvercle boitier | 10000.00 CHF | Plaque | 1000 | 2.00 CHF | 2000.00 CHF
Technicians cost [CHF/hours] | 80.00 CHF | Full time [Hours/quarter] | 640 | Casquette | 8000.00 CHF | Vis | 1000 | 5.00 CHF | 5000.00 CHF
Unit subscription [CHF/year] | 3000.00 CHF | Half time [Hours/quarter] | 320 | Capot vitre | 5000.00 CHF | Grenouillère | 1000 | 10.00 CHF | 10000.00 CHF
Unit manufacturing costs [CHF/year] | 191.44 CHF | 30% time [Hours/quarter] | 192 | Support batterie | 10000.00 CHF | Tube | 1000 | 2.00 CHF | 2000.00 CHF
Unit installation costs | 120.00 CHF |  |  | Support Lidar | 7000.00 CHF | Collier | 1000 | 15.00 CHF | 15000.00 CHF
Unit total costs | 311.44 CHF |  |  |  |  | Vitre | 1000 | 8.00 CHF | 8000.00 CHF
 |  |  |  | Total : | 50000.00 CHF |  |  |  | 47120.00 CHF
Unit maintenance costs | 500.00 CHF |  |  | Estimated case price | 97.12 CHF
Manufacturing costs detail
Case | 97.12 CHF
Electronics
PCB with components | 9.80 CHF
Sensor | 70.00 CHF
Batteries 6x | 14.52 CHF
Total unit price: | 191.44 CHF

Sheet: Base case
Year | 2021 |  | 2022 |  |  |  | 2023 |  |  |  | 2024
Quarter | Q3 | Q4 | Q1 | Q2 | Q3 | Q4 | Q1 | Q2 | Q3 | Q4 | Q1 | Q2 | Q3 | Q4
Units solds | 0 | 0 | 0 | 0 | 30 | 5 | 0 | 0 | 30 | 0 | 0 | 0 | 30 | 0
Total solds | 0 | 0 | 0 | 0 | 30 | 35 | 35 | 35 | 65 | 65 | 65 | 65 | 95 | 95
 | Revenues
Subscriptions | 0.00 CHF | 0.00 CHF | 0.00 CHF | 0.00 CHF |  | 105000.00 CHF | 0.00 CHF | 0.00 CHF | 0.00 CHF | 195000.00 CHF | 0.00 CHF | 0.00 CHF | 0.00 CHF | 285000.00 CHF
Total revenues | 0.00 CHF | 0.00 CHF | 0.00 CHF | 0.00 CHF | 0.00 CHF | 105000.00 CHF | 0.00 CHF | 0.00 CHF | 0.00 CHF | 195000.00 CHF | 0.00 CHF | 0.00 CHF | 0.00 CHF | 285000.00 CHF
 | Costs
Units costs | 0.00 CHF | 0.00 CHF | 0.00 CHF | 0.00 CHF | 9343.20 CHF | 1557.20 CHF | 0.00 CHF | 0.00 CHF | 9343.20 CHF | 0.00 CHF | 0.00 CHF | 0.00 CHF | 9343.20 CHF | 0.00 CHF
Units maintenance | 0.00 CHF | 0.00 CHF | 0.00 CHF | 0.00 CHF | 0.00 CHF | 0.00 CHF | 0.00 CHF | 0.00 CHF | 0.00 CHF | 12443.60 CHF | 0.00 CHF | 0.00 CHF | 0.00 CHF | 18186.80 CHF
Engineering costs | 42240.00 CHF | 42240.00 CHF | 42240.00 CHF | 105600.00 CHF | 105600.00 CHF | 63360.00 CHF | 63360.00 CHF | 42240.00 CHF | 42240.00 CHF | 42240.00 CHF | 14080.00 CHF | 14080.00 CHF | 14080.00 CHF | 14080.00 CHF
Secretaries costs | 0.00 CHF | 0.00 CHF | 0.00 CHF | 0.00 CHF | 11520.00 CHF | 19200.00 CHF | 19200.00 CHF | 19200.00 CHF | 19200.00 CHF | 19200.00 CHF | 19200.00 CHF | 19200.00 CHF | 19200.00 CHF | 19200.00 CHF
Technicians costs | 0.00 CHF | 0.00 CHF | 0.00 CHF | 0.00 CHF | 25600.00 CHF | 25600.00 CHF | 25600.00 CHF | 25600.00 CHF | 25600.00 CHF | 25600.00 CHF | 25600.00 CHF | 25600.00 CHF | 25600.00 CHF | 25600.00 CHF
Marekting | 0.00 CHF | 0.00 CHF | 0.00 CHF | 0.00 CHF | 2000.00 CHF | 300.00 CHF | 300.00 CHF | 300.00 CHF | 1000.00 CHF | 300.00 CHF | 300.00 CHF | 300.00 CHF | 1000.00 CHF | 300.00 CHF
Website | 0.00 CHF | 0.00 CHF | 0.00 CHF | 0.00 CHF | 2000.00 CHF | 200.00 CHF | 0.00 CHF | 0.00 CHF | 0.00 CHF | 200.00 CHF | 0.00 CHF | 0.00 CHF | 0.00 CHF | 200.00 CHF
Total costs | 42240.00 CHF | 42240.00 CHF | 42240.00 CHF | 105600.00 CHF | 156063.20 CHF | 110217.20 CHF | 108460.00 CHF | 87340.00 CHF | 97383.20 CHF | 99983.60 CHF | 59180.00 CHF | 59180.00 CHF | 69223.20 CHF | 77566.80 CHF
Balance | -42240.00 CHF | -84480.00 CHF | -126720.00 CHF | -232320.00 CHF | -388383.20 CHF | -393600.40 CHF | -502060.40 CHF | -589400.40 CHF | -686783.60 CHF | -591767.20 CHF | -650947.20 CHF | -710127.20 CHF | -779350.40 CHF | -571917.20 CHF

Sheet: Worst case
Year | 2021 |  | 2022 |  |  |  | 2023 |  |  |  | 2024
Quarter | Q3 | Q4 | Q1 | Q2 | Q3 | Q4 | Q1 | Q2 | Q3 | Q4 | Q1 | Q2 | Q3 | Q4
Units solds | 0 | 0 | 0 | 0 | 30 | 5 | 0 | 0 | 0 | 0 | 0 | 0 | 0 | 0
Total solds | 0 | 0 | 0 | 0 | 30 | 35 | 0 | 0 | 0 | 0 | 0 | 0 | 0 | 0
 | Revenues
Subscriptions | 0.00 CHF | 0.00 CHF | 0.00 CHF | 0.00 CHF |  | 105000.00 CHF | 0.00 CHF | 0.00 CHF | 0.00 CHF | 0.00 CHF | 0.00 CHF | 0.00 CHF | 0.00 CHF | 0.00 CHF
Total revenues | 0.00 CHF | 0.00 CHF | 0.00 CHF | 0.00 CHF | 0.00 CHF | 105000.00 CHF | 0.00 CHF | 0.00 CHF | 0.00 CHF | 0.00 CHF | 0.00 CHF | 0.00 CHF | 0.00 CHF | 0.00 CHF
 | Costs
Units costs | 0.00 CHF | 0.00 CHF | 0.00 CHF | 0.00 CHF | 9343.20 CHF | 1557.20 CHF | 0.00 CHF | 0.00 CHF | 0.00 CHF | 0.00 CHF | 0.00 CHF | 0.00 CHF | 0.00 CHF | 0.00 CHF
Units maintenance | 0.00 CHF | 0.00 CHF | 0.00 CHF | 0.00 CHF | 0.00 CHF | 0.00 CHF | 0.00 CHF | 0.00 CHF | 0.00 CHF | 0.00 CHF | 0.00 CHF | 0.00 CHF | 0.00 CHF | 0.00 CHF
Engineering costs | 42240.00 CHF | 42240.00 CHF | 42240.00 CHF | 105600.00 CHF | 105600.00 CHF | 63360.00 CHF | 63360.00 CHF | 0.00 CHF | 0.00 CHF | 0.00 CHF | 0.00 CHF | 0.00 CHF | 0.00 CHF | 0.00 CHF
Secretaries costs | 0.00 CHF | 0.00 CHF | 0.00 CHF | 0.00 CHF | 11520.00 CHF | 19200.00 CHF | 19200.00 CHF | 0.00 CHF | 0.00 CHF | 0.00 CHF | 0.00 CHF | 0.00 CHF | 0.00 CHF | 0.00 CHF
Technicians costs | 0.00 CHF | 0.00 CHF | 0.00 CHF | 0.00 CHF | 25600.00 CHF | 25600.00 CHF | 25600.00 CHF | 0.00 CHF | 0.00 CHF | 0.00 CHF | 0.00 CHF | 0.00 CHF | 0.00 CHF | 0.00 CHF
Marekting | 0.00 CHF | 0.00 CHF | 0.00 CHF | 0.00 CHF | 2000.00 CHF | 300.00 CHF | 300.00 CHF | 0.00 CHF | 0.00 CHF | 0.00 CHF | 0.00 CHF | 0.00 CHF | 0.00 CHF | 0.00 CHF
Website | 0.00 CHF | 0.00 CHF | 0.00 CHF | 0.00 CHF | 2000.00 CHF | 200.00 CHF | 0.00 CHF | 0.00 CHF | 0.00 CHF | 0.00 CHF | 0.00 CHF | 0.00 CHF | 0.00 CHF | 0.00 CHF
Total costs | 42240.00 CHF | 42240.00 CHF | 42240.00 CHF | 105600.00 CHF | 156063.20 CHF | 110217.20 CHF | 108460.00 CHF | 0.00 CHF | 0.00 CHF | 0.00 CHF | 0.00 CHF | 0.00 CHF | 0.00 CHF | 0.00 CHF
Balance | -42240.00 CHF | -84480.00 CHF | -126720.00 CHF | -232320.00 CHF | -388383.20 CHF | -393600.40 CHF | -502060.40 CHF | -502060.40 CHF | -502060.40 CHF | -502060.40 CHF | -502060.40 CHF | -502060.40 CHF | -502060.40 CHF | -502060.40 CHF
 |  |  |  |  |  | Produit ne plait pas | Fin d'activité

Sheet: Best case
Year | 2021 |  | 2022 |  |  |  | 2023 |  |  |  | 2024
Quarter | Q3 | Q4 | Q1 | Q2 | Q3 | Q4 | Q1 | Q2 | Q3 | Q4 | Q1 | Q2 | Q3 | Q4
Units solds | 0 | 0 | 0 | 0 | 30 | 5 | 0 | 0 | 90 | 15 | 0 | 0 | 60 | 0
Total solds | 0 | 0 | 0 | 0 | 30 | 35 | 35 | 35 | 125 | 140 | 140 | 140 | 200 | 200
 | Revenues
Subscriptions | 0.00 CHF | 0.00 CHF | 0.00 CHF | 0.00 CHF |  | 105000.00 CHF | 0.00 CHF | 0.00 CHF | 0.00 CHF | 420000.00 CHF | 0.00 CHF | 0.00 CHF | 0.00 CHF | 600000.00 CHF
Total revenues | 0.00 CHF | 0.00 CHF | 0.00 CHF | 0.00 CHF | 0.00 CHF | 105000.00 CHF | 0.00 CHF | 0.00 CHF | 0.00 CHF | 420000.00 CHF | 0.00 CHF | 0.00 CHF | 0.00 CHF | 600000.00 CHF
 | Costs
Units costs | 0.00 CHF | 0.00 CHF | 0.00 CHF | 0.00 CHF | 9343.20 CHF | 1557.20 CHF | 0.00 CHF | 0.00 CHF | 28029.60 CHF | 4671.60 CHF | 0.00 CHF | 0.00 CHF | 18686.40 CHF | 0.00 CHF
Units maintenance | 0.00 CHF | 0.00 CHF | 0.00 CHF | 0.00 CHF | 0.00 CHF | 0.00 CHF | 0.00 CHF | 0.00 CHF | 0.00 CHF | 12443.60 CHF | 0.00 CHF | 0.00 CHF | 0.00 CHF | 18186.80 CHF
Engineering costs | 42240.00 CHF | 42240.00 CHF | 42240.00 CHF | 105600.00 CHF | 105600.00 CHF | 63360.00 CHF | 63360.00 CHF | 42240.00 CHF | 42240.00 CHF | 42240.00 CHF | 14080.00 CHF | 14080.00 CHF | 14080.00 CHF | 14080.00 CHF
Secretaries costs | 0.00 CHF | 0.00 CHF | 0.00 CHF | 0.00 CHF | 11520.00 CHF | 19200.00 CHF | 19200.00 CHF | 19200.00 CHF | 19200.00 CHF | 19200.00 CHF | 19200.00 CHF | 19200.00 CHF | 19200.00 CHF | 19200.00 CHF
Technicians costs | 0.00 CHF | 0.00 CHF | 0.00 CHF | 0.00 CHF | 25600.00 CHF | 25600.00 CHF | 25600.00 CHF | 25600.00 CHF | 25600.00 CHF | 25600.00 CHF | 25600.00 CHF | 25600.00 CHF | 25600.00 CHF | 25600.00 CHF
Marekting | 0.00 CHF | 0.00 CHF | 0.00 CHF | 0.00 CHF | 2000.00 CHF | 300.00 CHF | 300.00 CHF | 300.00 CHF | 1000.00 CHF | 300.00 CHF | 300.00 CHF | 300.00 CHF | 1000.00 CHF | 300.00 CHF
Website | 0.00 CHF | 0.00 CHF | 0.00 CHF | 0.00 CHF | 2000.00 CHF | 200.00 CHF | 0.00 CHF | 0.00 CHF | 0.00 CHF | 200.00 CHF | 0.00 CHF | 0.00 CHF | 0.00 CHF | 200.00 CHF
Total costs | 42240.00 CHF | 42240.00 CHF | 42240.00 CHF | 105600.00 CHF | 156063.20 CHF | 110217.20 CHF | 108460.00 CHF | 87340.00 CHF | 116069.60 CHF | 104655.20 CHF | 59180.00 CHF | 59180.00 CHF | 78566.40 CHF | 77566.80 CHF
Balance | -42240.00 CHF | -84480.00 CHF | -126720.00 CHF | -232320.00 CHF | -388383.20 CHF | -393600.40 CHF | -502060.40 CHF | -589400.40 CHF | -705470.00 CHF | -390125.20 CHF | -449305.20 CHF | -508485.20 CHF | -587051.60 CHF | -64618.40 CHF
