SamyFrancelet/LoRaSnow/0000_Docs/0006_Branding/moule_cmd.xls

 | Personne concernée: | Michel Truc
 | Mandat no.: | 72777 | Chef de projet / professeur: | Mon chef
 | Acronyme du projet: | SCCER
 | Salle: | A304 | Délai désiré | 2018-05-01
 | Mouser |  |  | Monnaie | CHF
 | Quantity | Reference | Designation | Unit Price
 | 1 | 123456 | Bidule chose | 8.80 | 8.80
 |  |  |  |  | 0.00
 |  |  |  |  | 0.00
 |  |  |  |  | 0.00
 |  |  |  |  | 0.00
 |  |  |  |  | 0.00
 |  |  |  |  | 0.00
 |  |  |  |  | 0.00
 |  |  |  |  | 0.00
 |  |  |  |  | 0.00
 |  |  |  |  | 0.00
 |  |  |  |  | 0.00
 |  |  |  |  | 0.00
 |  |  |  |  | 0.00
 |  |  |  |  | 8.80
 | Distrelec |  |  | Monnaie | CHF
 | Quantity | Reference | Designation | Unit Price
 | 1 | 112233 | Truc machin | 2.20 | 2.20
 |  |  |  |  | 0.00
 |  |  |  |  | 0.00
 |  |  |  |  | 0.00
 |  |  |  |  | 0.00
 |  |  |  |  | 0.00
 |  |  |  |  | 0.00
 |  |  |  |  | 0.00
 |  |  |  |  | 0.00
 |  |  |  |  | 0.00
 |  |  |  |  | 0.00
 |  |  |  |  | 0.00
 |  |  |  |  | 0.00
 |  |  |  |  | 0.00
 |  |  |  |  | 2.20
 | Adress complète si fournisseur pas classique
 | Schneider Electric |  |  | Monnaie | CHF
 | Route du truc 123
 | CH-1234 Trucville
Phone | +41 44 23456789
Fax | +41 234567890
 | Quantity | Reference | Designation | Unit Price
 | 1 | 112233 | Truc machin | 1.10 | 1.10
 |  |  |  |  | 0.00
 |  |  |  |  | 0.00
 |  |  |  |  | 1.10
