SamyFrancelet/LoRaSnow/0200_Hardware/LoRaSnow_shield/LoRaSnow_shield.step

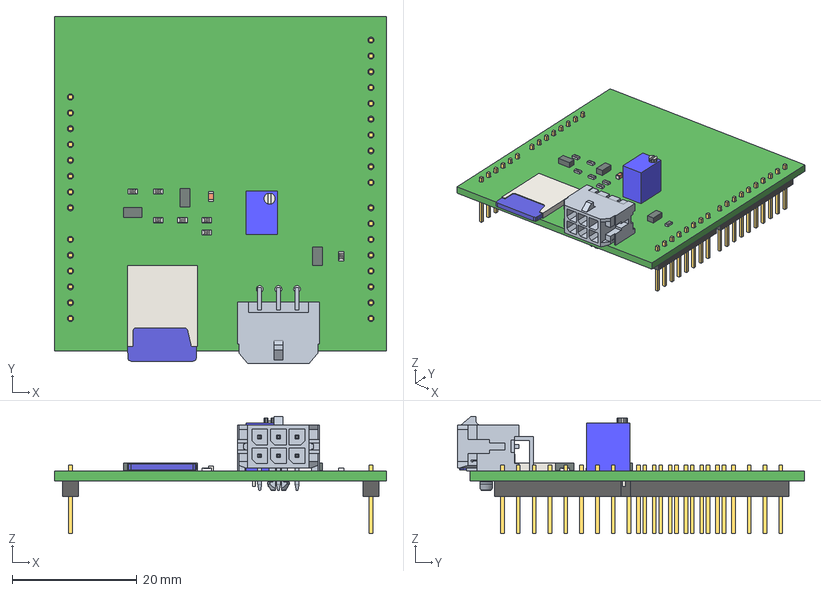
[picture p184: CAD file, 2022-01-18]
0200_Hardware/LoRaSnow_shield/LoRaSnow_shield.step
53.4 x 55.7 x 18.9 mm
Extruded x 48
User_Library-RESC1608X05N x 7
