SamyFrancelet/LoRaSnow/0300_Mechanical/PGA/Composants normalisés/B-L072Z-LRWAN1.step

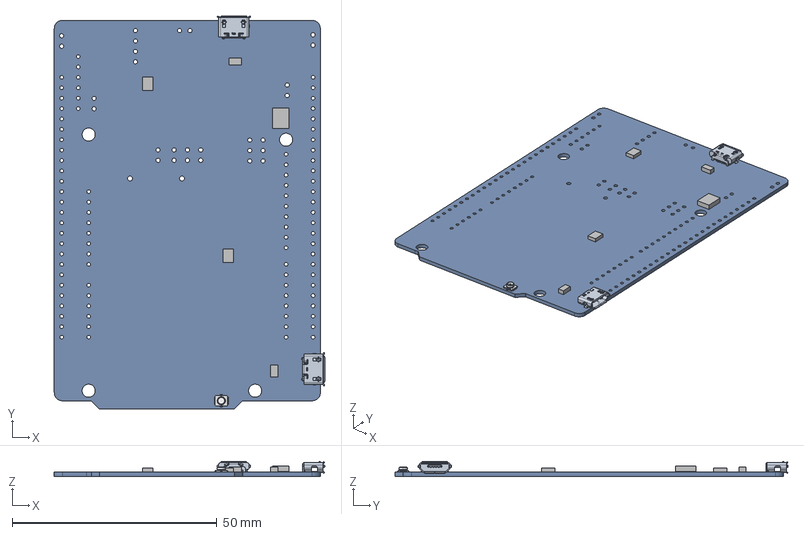
[picture p185: CAD file, 2022-01-18]
0300_Mechanical/PGA/Composants normalisés/B-L072Z-LRWAN1.step
66.1 x 96.1 x 3.63 mm
Extruded x 5
SW3dPS-UFL-R-SMD_Part_525
SW3dPS-UFL-R-SMD_Part_540
SW3dPS-UFL-R-SMD_Part_739
SW3dPS-UFL-R-SMD_Part_555
SW3dPS-UFL-R-SMD_Part_578
SW3dPS-UFL-R-SMD_Part_562
