SamyFrancelet/LoRaSnow/(list of files, cad)

Other CAD files:
0300_Mechanical/PGA/Composants normalisés/01621_01-2-016210-01-0.ipt
0300_Mechanical/PGA/Composants normalisés/02062_Bearbeitung n. Zeichn. (01-2-021510-03-0).ipt
0300_Mechanical/PGA/Composants normalisés/1050170001.iam
0300_Mechanical/PGA/Composants normalisés/18650 Battery.ipt
0300_Mechanical/PGA/Composants normalisés/6688609584.iam
0300_Mechanical/PGA/Composants normalisés/6688609984.iam
0300_Mechanical/PGA/Composants normalisés/6688610624.iam
0300_Mechanical/PGA/Composants normalisés/6688610944.iam
0300_Mechanical/PGA/Composants normalisés/93134.ipt
0300_Mechanical/PGA/Composants normalisés/99999_1040_F_r Deckel 02062.ipt
0300_Mechanical/PGA/Composants normalisés/B-L072Z-LRWAN1.iam
0300_Mechanical/PGA/Composants normalisés/Board.iam
0300_Mechanical/PGA/Composants normalisés/Boitier_Phoenix_A150.iam
0300_Mechanical/PGA/Composants normalisés/CN11.iam
0300_Mechanical/PGA/Composants normalisés/CN7.iam
0300_Mechanical/PGA/Composants normalisés/CN9.iam
0300_Mechanical/PGA/Composants normalisés/Extruded.ipt
0300_Mechanical/PGA/Composants normalisés/Extruded_1.ipt
0300_Mechanical/PGA/Composants normalisés/Extruded_2.ipt
0300_Mechanical/PGA/Composants normalisés/Extruded_3.ipt
0300_Mechanical/PGA/Composants normalisés/Open CASCADE STEP translator 6.8 1.1.1.ipt
0300_Mechanical/PGA/Composants normalisés/Open CASCADE STEP translator 6.8 1.4.1.1.ipt
0300_Mechanical/PGA/Composants normalisés/Open CASCADE STEP translator 6.8 1.4.1.2.ipt
0300_Mechanical/PGA/Composants normalisés/SW3dPS-UFL-R-SMD_Part_525.ipt
0300_Mechanical/PGA/Composants normalisés/SW3dPS-UFL-R-SMD_Part_540.ipt
0300_Mechanical/PGA/Composants normalisés/SW3dPS-UFL-R-SMD_Part_555.ipt
0300_Mechanical/PGA/Composants normalisés/SW3dPS-UFL-R-SMD_Part_562.ipt
0300_Mechanical/PGA/Composants normalisés/SW3dPS-UFL-R-SMD_Part_578.ipt
0300_Mechanical/PGA/Composants normalisés/SW3dPS-UFL-R-SMD_Part_739.ipt
0300_Mechanical/PGA/Composants normalisés/Shield430450600.iam
0300_Mechanical/PGA/Composants normalisés/Shield6593481520.iam
0300_Mechanical/PGA/Composants normalisés/Shield6593484640.iam
0300_Mechanical/PGA/Composants normalisés/Shield6593485600.iam
0300_Mechanical/PGA/Composants normalisés/Shield6593485760.iam
0300_Mechanical/PGA/Composants normalisés/Shield6593486080.iam
0300_Mechanical/PGA/Composants normalisés/Shield6593486160.iam
0300_Mechanical/PGA/Composants normalisés/Shield6593486560.iam
0300_Mechanical/PGA/Composants normalisés/Shield6593487120.iam
0300_Mechanical/PGA/Composants normalisés/Shield6593488160.iam
0300_Mechanical/PGA/Composants normalisés/Shield6593488960.iam
0300_Mechanical/PGA/Composants normalisés/Shield6593489280.iam
0300_Mechanical/PGA/Composants normalisés/Shield6593490560.iam
0300_Mechanical/PGA/Composants normalisés/Shield6593490640.iam
0300_Mechanical/PGA/Composants normalisés/Shield6593491040.iam
0300_Mechanical/PGA/Composants normalisés/Shield6593491440.iam
0300_Mechanical/PGA/Composants normalisés/ShieldB1.iam
0300_Mechanical/PGA/Composants normalisés/ShieldBoard.iam
0300_Mechanical/PGA/Composants normalisés/ShieldC1.iam
0300_Mechanical/PGA/Composants normalisés/ShieldCylinder.ipt
0300_Mechanical/PGA/Composants normalisés/ShieldExtruded.ipt
0300_Mechanical/PGA/Composants normalisés/ShieldExtruded_1.ipt
0300_Mechanical/PGA/Composants normalisés/ShieldExtruded_10.ipt
0300_Mechanical/PGA/Composants normalisés/ShieldExtruded_11.ipt
0300_Mechanical/PGA/Composants normalisés/ShieldExtruded_12.ipt
0300_Mechanical/PGA/Composants normalisés/ShieldExtruded_13.ipt
0300_Mechanical/PGA/Composants normalisés/ShieldExtruded_2.ipt
0300_Mechanical/PGA/Composants normalisés/ShieldExtruded_3.ipt
0300_Mechanical/PGA/Composants normalisés/ShieldExtruded_4.ipt
0300_Mechanical/PGA/Composants normalisés/ShieldExtruded_5.ipt
0300_Mechanical/PGA/Composants normalisés/ShieldExtruded_6.ipt
0300_Mechanical/PGA/Composants normalisés/ShieldExtruded_7.ipt
0300_Mechanical/PGA/Composants normalisés/ShieldExtruded_8.ipt
0300_Mechanical/PGA/Composants normalisés/ShieldExtruded_9.ipt
0300_Mechanical/PGA/Composants normalisés/ShieldJ1.iam
0300_Mechanical/PGA/Composants normalisés/ShieldJ2.iam
0300_Mechanical/PGA/Composants normalisés/ShieldLoRaSnow_shield.iam
0300_Mechanical/PGA/Composants normalisés/ShieldOpen CASCADE STEP translator 6.8 1.1.1.ipt
0300_Mechanical/PGA/Composants normalisés/ShieldOpen CASCADE STEP translator 6.8 1.15.1.1.ipt
0300_Mechanical/PGA/Composants normalisés/ShieldOpen CASCADE STEP translator 6.8 1.15.1.2.ipt
0300_Mechanical/PGA/Composants normalisés/ShieldR1.iam
0300_Mechanical/PGA/Composants normalisés/ShieldR2.iam
0300_Mechanical/PGA/Composants normalisés/ShieldR3.iam
0300_Mechanical/PGA/Composants normalisés/ShieldR4.iam
0300_Mechanical/PGA/Composants normalisés/ShieldR5.iam
0300_Mechanical/PGA/Composants normalisés/ShieldR6.iam
0300_Mechanical/PGA/Composants normalisés/ShieldR7.iam
0300_Mechanical/PGA/Composants normalisés/ShieldR8.iam
0300_Mechanical/PGA/Composants normalisés/ShieldT1.iam
0300_Mechanical/PGA/Composants normalisés/ShieldT2.iam
0300_Mechanical/PGA/Composants normalisés/ShieldU1.iam
0300_Mechanical/PGA/Composants normalisés/ShieldUser_Library-RESC1608X05N.ipt
0300_Mechanical/PGA/Composants normalisés/U5.iam
0300_Mechanical/PGA/Composants normalisés/U6.iam
0300_Mechanical/PGA/Composants normalisés/U8.iam
0300_Mechanical/PGA/Composants normalisés/UFL-R-SMD.iam
0300_Mechanical/PGA/Composants normalisés/X1.iam
0300_Mechanical/PGA/Composants normalisés/X2.iam
0300_Mechanical/PGA/E001_BancDeTest.iam
0300_Mechanical/PGA/E002_Canon.iam
0300_Mechanical/PGA/E003_BoitierEcran.iam
0300_Mechanical/PGA/E004_BoitierDeProtection.iam
0300_Mechanical/PGA/E005_Boitier_v3.iam
0300_Mechanical/PGA/E006_Boitier_v4.iam
0300_Mechanical/PGA/E007_Boitier_v4_moduleElectronique.iam
0300_Mechanical/PGA/OldVersions/01621_01-2-016210-01-0.0002.ipt
0300_Mechanical/PGA/OldVersions/Boitier_Phoenix_A150.0003.iam
0300_Mechanical/PGA/OldVersions/E001_BancDeTest.0004.iam
0300_Mechanical/PGA/OldVersions/E002_Canon.0010.iam
0300_Mechanical/PGA/OldVersions/E003_BoitierEcran.0011.iam
0300_Mechanical/PGA/OldVersions/E004_BoitierDeProtection.0005.iam
0300_Mechanical/PGA/OldVersions/E005_Boitier_v3.0009.iam
0300_Mechanical/PGA/OldVersions/E006_Boitier_v4.0030.iam
0300_Mechanical/PGA/OldVersions/E007_Boitier_v4_moduleElectronique.0011.iam
0300_Mechanical/PGA/OldVersions/P001_CageDeTest.0004.ipt
0300_Mechanical/PGA/OldVersions/P002_plancher.0002.ipt
0300_Mechanical/PGA/OldVersions/P003_tripod.0001.ipt
0300_Mechanical/PGA/OldVersions/P004_CageDeTest2.0005.ipt
0300_Mechanical/PGA/OldVersions/P005_supportCapteursTripod.0004.ipt
0300_Mechanical/PGA/OldVersions/P006_CanonConfettis.0002.ipt
0300_Mechanical/PGA/OldVersions/P007_CanonSupportRervoir.0006.ipt
0300_Mechanical/PGA/OldVersions/P008_CanonBout.0005.ipt
0300_Mechanical/PGA/OldVersions/P009_CanonAdaptateurReservoir.0002.ipt
0300_Mechanical/PGA/OldVersions/P010_CanonCoude.0002.ipt
0300_Mechanical/PGA/OldVersions/P011_Canon_AdaptVentilo.0002.ipt
0300_Mechanical/PGA/OldVersions/P012_Canon_AdaptCoudeTube.0001.ipt
0300_Mechanical/PGA/OldVersions/P013_Canon_venturiCoudé.0012.ipt
0300_Mechanical/PGA/OldVersions/P014_CanonSupportReservoirv2.0005.ipt
0300_Mechanical/PGA/OldVersions/P015_CanonAdaptateurReservoirv2.0002.ipt
0300_Mechanical/PGA/OldVersions/P016_FondBoitierCapteurs.0006.ipt
0300_Mechanical/PGA/OldVersions/P017_BoiteEssai.0002.ipt
0300_Mechanical/PGA/OldVersions/P018_BasEcranProtecLidar.0005.ipt
0300_Mechanical/PGA/OldVersions/P019_EcranProtecLidar.0002.ipt
0300_Mechanical/PGA/OldVersions/P020_Joint.0002.ipt
0300_Mechanical/PGA/OldVersions/P021_HautEcranProtecLidar.0002.ipt
0300_Mechanical/PGA/OldVersions/P022_Coque_boitier.0003.ipt
0300_Mechanical/PGA/OldVersions/P023_Chapeau.0002.ipt
0300_Mechanical/PGA/OldVersions/P024_ReservoirSilica.0003.ipt
0300_Mechanical/PGA/OldVersions/P025_Batterie.0001.ipt
0300_Mechanical/PGA/OldVersions/P026_Socle_Boitier.0002.ipt
0300_Mechanical/PGA/OldVersions/P027_SurSocle_Boitier.0001.ipt
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
