SamyFrancelet/LoRaSnow/0100_Research/0120_Prototypes/0122_LiDarLitev4/4_RealTest/RealTestResults.xlsx

Heure | Mesure réelle | Mesure LiDAR | Type de neige
4:28:00 | 0.00 | 0 | Petits flocons, peu de vent
4:28:30 | 0.02 | 0 | Petits flocons, peu de vent
4:29:00 | 0.05 | 0 | Petits flocons, peu de vent
4:29:30 | 0.07 | 0 | Petits flocons, peu de vent
4:30:00 | 0.09 | 0 | Petits flocons, peu de vent
4:30:30 | 0.11 | 0 | Petits flocons, peu de vent
4:31:00 | 0.14 | 0 | Petits flocons, peu de vent
4:31:30 | 0.16 | 0 | Petits flocons, peu de vent
4:32:00 | 0.18 | 0 | Petits flocons, peu de vent
4:32:30 | 0.20 | 0 | Petits flocons, peu de vent
4:33:00 | 0.23 | 0 | Petits flocons, peu de vent
4:33:30 | 0.25 | 0.71 | Petits flocons, peu de vent
4:34:00 | 0.27 | 0 | Petits flocons, peu de vent
4:34:30 | 0.30 | 0 | Petits flocons, peu de vent
4:35:00 | 0.32 | 0 | Petits flocons, peu de vent
4:35:30 | 0.34 | 0 | Petits flocons, peu de vent
4:36:00 | 0.36 | 0 | Petits flocons, peu de vent
4:36:30 | 0.39 | 0.71 | Petits flocons, peu de vent
4:37:00 | 0.41 | 0 | Petits flocons, peu de vent
4:37:30 | 0.43 | 0.71 | Petits flocons, peu de vent
4:38:00 | 0.45 | 0 | Petits flocons, peu de vent
4:38:30 | 0.48 | 0 | Petits flocons, peu de vent
4:39:00 | 0.50 | 0.71 | Petits flocons, peu de vent
4:39:30 | 0.52 | 0.71 | Petits flocons, peu de vent
4:40:00 | 0.53 | 0.71 | Petits flocons, peu de vent
4:40:30 | 0.55 | 0.71 | Petits flocons, peu de vent
4:41:00 | 0.57 | 0.71 | Petits flocons, peu de vent
4:41:30 | 0.58 | 0.71 | Petits flocons, peu de vent
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
5:18:00 | 2.67 | 2.12 | Quelques gros flocons, pas de vent
5:18:30 | 2.69 | 2.12 | Quelques gros flocons, pas de vent
5:19:00 | 2.71 | 2.12 | Quelques gros flocons, pas de vent
5:19:30 | 2.74 | 2.86 | Quelques gros flocons, pas de vent
5:20:00 | 2.76 | 2.12 | Quelques gros flocons, pas de vent
5:20:30 | 2.78 | 2.86 | Quelques gros flocons, pas de vent
5:21:00 | 2.80 | 2.86 | Quelques gros flocons, pas de vent
5:21:30 | 2.81 | 2.86 | Quelques gros flocons, pas de vent
5:22:00 | 2.82 | 2.86 | Quelques gros flocons, pas de vent
5:22:30 | 2.83 | 2.86 | Quelques gros flocons, pas de vent
5:23:00 | 2.84 | 2.86 | Quelques gros flocons, pas de vent
5:23:30 | 2.85 | 2.86 | Quelques gros flocons, pas de vent
5:24:00 | 2.85 | 2.86 | Quelques gros flocons, pas de vent
5:24:30 | 2.86 | 2.86 | Quelques gros flocons, pas de vent
5:25:00 | 2.87 | 2.86 | Quelques gros flocons, pas de vent
5:25:30 | 2.88 | 2.86 | Quelques gros flocons, pas de vent
5:26:00 | 2.89 | 2.86 | Quelques gros flocons, pas de vent
5:26:30 | 2.90 | 2.86 | Quelques gros flocons, pas de vent
5:27:00 | 2.91 | 2.86 | Quelques gros flocons, pas de vent
5:27:30 | 2.92 | 2.86 | Quelques gros flocons, pas de vent
5:28:00 | 2.93 | 2.86 | Quelques gros flocons, pas de vent
5:28:30 | 2.94 | 2.86 | Quelques gros flocons, pas de vent
5:29:00 | 2.95 | 2.86 | Quelques gros flocons, pas de vent
5:29:30 | 2.95 | 2.86 | Quelques gros flocons, pas de vent
5:30:00 | 2.96 | 2.86 | Quelques gros flocons, pas de vent
5:30:30 | 2.97 | 2.86 | Quelques gros flocons, pas de vent
5:31:00 | 2.98 | 2.86 | Quelques gros flocons, pas de vent
5:31:30 | 2.99 | 2.86 | Quelques gros flocons, pas de vent
5:32:00 | 3.00 | 2.86 | Quelques gros flocons, pas de vent
