SamyFrancelet/LoRaSnow/0100_Research/0120_Prototypes/0122_LiDarLitev4/2_TemperatureStability/211022_TempStabilityTest.xlsx

-15°C | -10°C | -5°C | 0°C | 5°C | 10°C | 15°C | 20°C | 25°C | 30°C | 35°C | 40°C | Temperature | -15 | -10 | -5 | 0 | 5 | 10 | 15 | 20 | 25 | 30 | 35 | 40
47 | 47 | 48 | 48 | 48 | 48 | 48 | 46 | 47 | 47 | 47 | 46 | Mean | 46.21 | 46.76 | 47.36 | 47.83 | 47.73 | 47.04 | 46.64 | 46.81 | 46.19 | 45.59 | 45.5 | 45.17
47 | 47 | 48 | 48 | 48 | 47 | 47 | 47 | 46 | 46 | 46 | 46 | Median | 46 | 47 | 47 | 48 | 48 | 47 | 47 | 47 | 46 | 46 | 45 | 45
47 | 47 | 48 | 48 | 48 | 47 | 47 | 46 | 47 | 46 | 45 | 45 | StdDev | 4.622566258 | 4.683042931 | 4.736878698 | 4.774063591 | 4.770017747 | 4.691154516 | 4.667753292 | 4.680674403 | 4.619288017 | 4.569528866 | 4.559333806 | 4.512468974
48 | 47 | 47 | 48 | 48 | 47 | 47 | 46 | 46 | 46 | 46 | 45 | Min | 45 | 46 | 47 | 47 | 47 | 46 | 46 | 46 | 45 | 45 | 45 | 45
48 | 47 | 48 | 48 | 48 | 47 | 46 | 47 | 47 | 46 | 45 | 45 | Max | 48 | 48 | 48 | 48 | 48 | 48 | 48 | 48 | 47 | 47 | 47 | 47
47 | 47 | 48 | 48 | 48 | 48 | 46 | 47 | 46 | 46 | 46 | 46 | Negative Err | 1 | 1 | 0 | 1 | 1 | 1 | 1 | 1 | 1 | 1 | 0 | 0
47 | 48 | 48 | 48 | 48 | 47 | 46 | 47 | 46 | 46 | 46 | 46 | Postive Err | 2 | 1 | 1 | 0 | 0 | 1 | 1 | 1 | 1 | 1 | 2 | 2
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
