SamyFrancelet/LoRaSnow/0100_Research/0120_Prototypes/0122_LiDarLitev4/3_OffsetMeasurments/21116_OffsetMeasures.xlsx

Offset no noise | Ground no noise | Noise 1 | Noise 2 | Noise 3
148 | 153 | 147 | 146 | 145
147 | 154 | 145 | 147 | 144 |  |  |  |  |  |  |  |  |  |  |  | u
147 | 153 | 145 | 146 | 140
148 | 154 | 144 | 145 | 141
147 | 152 | 145 | 146 | 144
147 | 153 | 135 | 143 | 142
147 | 154 | 144 | 141 | 142
147 | 153 | 146 | 142 | 140
147 | 153 | 147 | 146 | 144
148 | 153 | 146 | 141 | 133
147 | 154 | 143 | 141 | 136
148 | 154 | 139 | 143 | 142
147 | 154 | 144 | 145 | 119
148 | 154 | 146 | 141 | 133
147 | 153 | 146 | 144 | 142
148 | 155 | 146 | 144 | 131
147 | 154 | 145 | 140 | 142
148 | 154 | 146 | 146 | 140
147 | 152 | 147 | 139 | 135
147 | 155 | 145 | 144 | 134
148 | 154 | 146 | 144 | 137
147 | 156 | 144 | 142 | 143
147 | 154 | 147 | 135 | 143
147 | 154 | 141 | 140 | 138 |  |  |  |  |  |  |  |  |  |  |  |  |  | u | u
147 | 155 | 143 | 143 | 139
148 | 154 | 143 | 145 | 135
148 | 154 | 146 | 144 | 138
148 | 155 | 143 | 144 | 132
147 | 154 | 143 | 139 | 142
148 | 154 | 144 | 140 | 133
147 | 155 | 146 | 142 | 142
147 | 154 | 144 | 144 | 139
147 | 154 | 145 | 142 | 134
147 | 154 | 146 | 144 | 142
147 | 154 | 145 | 146 | 134
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
