SamyFrancelet/LoRaSnow/0100_Research/0120_Prototypes/0122_LiDarLitev4/0_ErrorCharacteristic/Error Characteristics.xlsx

Real distance [cm] | 20 | 40 | 60 | 80 | 100 | 150 | 200 | 250 | 300 | 350 | 400 | 450 | 500 | 550 | 600
Mesured distances [cm] | 23 | 45 | 62 | 82 | 101 | 145 | 198 | 245 | 304 | 358 | 496 | 609 | 1128 | 1119 | 1128
 | 23 | 44 | 63 | 81 | 100 | 148 | 198 | 244 | 301 | 361 | 447 | 620 | 1127 | 1129 | 1124
 | 23 | 44 | 62 | 82 | 101 | 148 | 197 | 247 | 304 | 361 | 491 | 654 | 1126 | 1125 | 1126
 | 23 | 44 | 62 | 82 | 100 | 147 | 199 | 312 | 303 | 357 | 585 | 701 | 1129 | 1124 | 1125
 | 23 | 44 | 63 | 81 | 101 | 148 | 199 | 245 | 301 | 364 | 400 | 659 | 1047 | 1130 | 1125
 | 23 | 44 | 63 | 81 | 102 | 147 | 196 | 273 | 305 | 358 | 447 | 827 | 1127 | 1140 | 1119
 | 24 | 43 | 63 | 82 | 100 | 147 | 199 | 246 | 306 | 362 | 450 | 742 | 1006 | 1127 | 1125
 | 23 | 44 | 62 | 82 | 99 | 147 | 198 | 248 | 301 | 360 | 540 | 833 | 1130 | 1123 | 1129
 | 24 | 44 | 62 | 82 | 101 | 149 | 197 | 276 | 312 | 359 | 495 | 659 | 1125 | 1122 | 1123
 | 23 | 44 | 62 | 81 | 100 | 146 | 199 | 245 | 304 | 358 | 544 | 745 | 1087 | 1123 | 1129
Mean distance [cm] | 23.2 | 44 | 62.4 | 81.6 | 100.5 | 147.2 | 198 | 258.1 | 304.1 | 359.8 | 489.5 | 704.9 | 1103.2 | 1126.2 | 1125.3
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
