SamyFrancelet/LoRaSnow/0100_Research/0120_Prototypes/0122_LiDarLitev4/1_NoiseQuantification/211022_ErrorMesTest.xlsx

Sheet: 2021-10-22_150600_Noise
Noise | No Noise
159 | 158
159 | 158 | Mean distance to floor | 158.57
159 | 158 | Std dev | 1.139333493
158 | 159
158 | 159
158 | 158 | Mean distance | 155.32
141 | 150 | Std dev | 4.510100897
156 | 158
151 | 158 | # samples | 100
151 | 159 | # error samples (1x stddev) | 61
150 | 158 | # error samples (2x stddev) | 44
152 | 159 | # error samples (3x stddev) | 33
156 | 159
154 | 159
158 | 159
150 | 159
155 | 158
159 | 159
157 | 159
159 | 158
157 | 158
157 | 158
157 | 160
158 | 160
156 | 159
155 | 158
157 | 160
153 | 159
157 | 159
158 | 157
150 | 159
150 | 158
143 | 159
157 | 158
153 | 159
156 | 160
158 | 160
154 | 160
152 | 159
155 | 158
156 | 159
158 | 158
157 | 159
156 | 159
154 | 159
155 | 159
146 | 159
152 | 159
153 | 160
144 | 160
152 | 160
156 | 158
154 | 159
155 | 159
156 | 160
155 | 158
157 | 158
142 | 159
156 | 159
145 | 159
158 | 159
152 | 159
158 | 159
156 | 159
157 | 158
156 | 158
158 | 158
158 | 158
157 | 158
154 | 157
133 | 159
158 | 160
159 | 159
155 | 157
157 | 158
158 | 159
157 | 159
158 | 159
159 | 158
157 | 158
157 | 158
158 | 159
159 | 157
158 | 158
158 | 158
159 | 159
158 | 158
158 | 158
159 | 158
160 | 159
159 | 159
158 | 158
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
