SamyFrancelet/LoRaSnow/0100_Research/0120_Prototypes/0121_OpenCV/snow_debit/logs/2021-11-12_150911/measure.csv

thr_100 | thr_120 | thr_140 | thr_160 | thr_180 | thr_200 | thr_220 | thr_240
0.999977 | 0.989336 | 0.982129 | 0.981172 | 0.910260 | 0.666891 | 0.408372 | 0.295615
0.792282 | 0.501781 | 0.299860 | 0.200866 | 0.126439 | 0.066745 | 0.018721 | 0.001003
0.791846 | 0.500091 | 0.299609 | 0.200602 | 0.126956 | 0.067021 | 0.019238 | 0.001051
0.797637 | 0.503307 | 0.299531 | 0.201318 | 0.127074 | 0.067161 | 0.019492 | 0.001113
0.794440 | 0.500329 | 0.298659 | 0.200765 | 0.126872 | 0.067363 | 0.019486 | 0.001152
0.793372 | 0.499183 | 0.298444 | 0.200479 | 0.126641 | 0.067012 | 0.019346 | 0.001087
0.799928 | 0.503021 | 0.300055 | 0.201312 | 0.127314 | 0.067412 | 0.019398 | 0.001165
0.794710 | 0.499876 | 0.298125 | 0.200664 | 0.126611 | 0.066810 | 0.019082 | 0.001126
0.795820 | 0.500195 | 0.297744 | 0.200505 | 0.126517 | 0.066768 | 0.018971 | 0.001117
0.804382 | 0.505479 | 0.297865 | 0.200397 | 0.127106 | 0.067070 | 0.018962 | 0.001051
0.798597 | 0.499147 | 0.296927 | 0.200137 | 0.126367 | 0.066637 | 0.018509 | 0.001029
0.798984 | 0.499378 | 0.297415 | 0.200361 | 0.126514 | 0.066823 | 0.018717 | 0.001064
0.802425 | 0.503356 | 0.298590 | 0.200586 | 0.127142 | 0.067161 | 0.019535 | 0.001087
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
