SamyFrancelet/LoRaSnow/0100_Research/0120_Prototypes/0121_OpenCV/snow_debit/logs/2021-11-12_151140/measure.csv

thr_100 | thr_120 | thr_140 | thr_160 | thr_180 | thr_200 | thr_220 | thr_240
1.000000 | 0.999723 | 0.990173 | 0.988145 | 0.985199 | 0.800501 | 0.567119 | 0.367067
0.985951 | 0.732139 | 0.471048 | 0.270150 | 0.185635 | 0.115120 | 0.059346 | 0.018363
0.888363 | 0.573135 | 0.322936 | 0.209183 | 0.133408 | 0.071764 | 0.022549 | 0.001592
0.856956 | 0.550407 | 0.308643 | 0.201410 | 0.127471 | 0.067100 | 0.018678 | 0.001012
0.841217 | 0.538265 | 0.302269 | 0.196260 | 0.122943 | 0.063727 | 0.016449 | 0.000739
0.841986 | 0.537891 | 0.301276 | 0.196299 | 0.123014 | 0.064115 | 0.016458 | 0.000661
0.840736 | 0.537350 | 0.300824 | 0.195915 | 0.122904 | 0.063779 | 0.016484 | 0.000700
0.835231 | 0.532249 | 0.298779 | 0.195573 | 0.122477 | 0.063646 | 0.016217 | 0.000684
0.808581 | 0.512744 | 0.288418 | 0.191426 | 0.118454 | 0.060625 | 0.014583 | 0.000407
0.810469 | 0.513467 | 0.288158 | 0.191510 | 0.118122 | 0.060544 | 0.014570 | 0.000387
0.847500 | 0.541732 | 0.303008 | 0.198184 | 0.125277 | 0.065091 | 0.017549 | 0.000937
0.854248 | 0.543743 | 0.303815 | 0.199268 | 0.125553 | 0.065433 | 0.017796 | 0.000928
0.821497 | 0.516563 | 0.289014 | 0.192012 | 0.118630 | 0.060853 | 0.014788 | 0.000420
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
