SamyFrancelet/LoRaSnow/0100_Research/0120_Prototypes/0121_OpenCV/snow_debit/logs/2021-11-12_151501/measure.csv

thr_100 | thr_120 | thr_140 | thr_160 | thr_180 | thr_200 | thr_220 | thr_240
1.000000 | 0.999961 | 0.993890 | 0.987266 | 0.986536 | 0.836195 | 0.605264 | 0.396722
0.982598 | 0.744401 | 0.455762 | 0.264727 | 0.186598 | 0.114089 | 0.052236 | 0.008122
0.903831 | 0.586572 | 0.317432 | 0.216595 | 0.133187 | 0.067428 | 0.016660 | 0.000781
0.815882 | 0.500143 | 0.276696 | 0.191696 | 0.113662 | 0.053584 | 0.009622 | 0.000023
0.782865 | 0.489414 | 0.276120 | 0.192458 | 0.116598 | 0.052458 | 0.007653 | 0.000013
0.776624 | 0.492350 | 0.277126 | 0.189010 | 0.111891 | 0.052295 | 0.007790 | 0.000023
0.779281 | 0.484160 | 0.275856 | 0.188408 | 0.113594 | 0.048359 | 0.004831 | 0.000000
0.784876 | 0.484746 | 0.273978 | 0.188815 | 0.112376 | 0.051989 | 0.008298 | 0.000016
0.778005 | 0.486462 | 0.276048 | 0.189281 | 0.113366 | 0.051680 | 0.008434 | 0.000020
0.779248 | 0.481126 | 0.274453 | 0.189798 | 0.111377 | 0.052093 | 0.008047 | 0.000020
0.773600 | 0.483138 | 0.274411 | 0.188844 | 0.115941 | 0.052012 | 0.008265 | 0.000020
0.782572 | 0.491836 | 0.276976 | 0.190726 | 0.112874 | 0.051149 | 0.007806 | 0.000013
0.791611 | 0.483783 | 0.275140 | 0.191768 | 0.112721 | 0.051790 | 0.008239 | 0.000016
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
