SamyFrancelet/LoRaSnow/0100_Research/0120_Prototypes/0121_OpenCV/snow_debit/logs/2021-11-12_152118/measure.csv

thr_100 | thr_120 | thr_140 | thr_160 | thr_180 | thr_200 | thr_220 | thr_240
0.051462 | 0.050641 | 0.049831 | 0.048962 | 0.048034 | 0.046676 | 0.025091 | 0.013714
0.082197 | 0.080980 | 0.079482 | 0.077663 | 0.075052 | 0.056367 | 0.024749 | 0.021917
0.082946 | 0.081553 | 0.080078 | 0.078522 | 0.076491 | 0.065521 | 0.025527 | 0.020684
0.084238 | 0.083086 | 0.081934 | 0.080690 | 0.078991 | 0.073063 | 0.028698 | 0.015534
0.084238 | 0.083086 | 0.081934 | 0.080690 | 0.078991 | 0.073063 | 0.028698 | 0.015534
0.073698 | 0.071038 | 0.068122 | 0.064557 | 0.060163 | 0.055146 | 0.025378 | 0.009128
0.051553 | 0.049600 | 0.047692 | 0.045944 | 0.044460 | 0.043053 | 0.034681 | 0.009779
0.051553 | 0.049600 | 0.047692 | 0.045944 | 0.044460 | 0.043053 | 0.034681 | 0.009779
0.059404 | 0.058109 | 0.056670 | 0.054938 | 0.052874 | 0.050488 | 0.044938 | 0.013363
0.059404 | 0.058109 | 0.056670 | 0.054938 | 0.052874 | 0.050488 | 0.044938 | 0.013363
0.067513 | 0.066449 | 0.065381 | 0.064277 | 0.062985 | 0.061374 | 0.057321 | 0.018945
0.067513 | 0.066449 | 0.065381 | 0.064277 | 0.062985 | 0.061374 | 0.057321 | 0.018945
0.069518 | 0.068405 | 0.067347 | 0.066208 | 0.064886 | 0.063171 | 0.053428 | 0.014424
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
