SamyFrancelet/LoRaSnow/0100_Research/0120_Prototypes/0121_OpenCV/snow_debit/logs/2021-11-12_152620/measure.csv

thr_100 | thr_120 | thr_140 | thr_160 | thr_180 | thr_200 | thr_220 | thr_240
0.148815 | 0.010352 | 0.006217 | 0.001898 | 0.000319 | 0.000000 | 0.000000 | 0.000000
0.831061 | 0.789997 | 0.595433 | 0.427113 | 0.147620 | 0.026237 | 0.009134 | 0.002956
0.844079 | 0.806898 | 0.673434 | 0.527409 | 0.266735 | 0.070238 | 0.010550 | 0.003704
0.837777 | 0.801247 | 0.644238 | 0.508245 | 0.233574 | 0.053919 | 0.008438 | 0.003213
0.837640 | 0.800723 | 0.640602 | 0.503519 | 0.230947 | 0.052689 | 0.008304 | 0.003190
0.836100 | 0.799642 | 0.635238 | 0.495713 | 0.217887 | 0.049053 | 0.008324 | 0.003138
0.836953 | 0.799876 | 0.637923 | 0.494388 | 0.218542 | 0.050687 | 0.008255 | 0.003112
0.840179 | 0.801331 | 0.650732 | 0.498288 | 0.217884 | 0.052764 | 0.008219 | 0.003021
0.838177 | 0.801348 | 0.653936 | 0.502673 | 0.229482 | 0.055361 | 0.008451 | 0.003132
0.838493 | 0.802887 | 0.647939 | 0.497786 | 0.214404 | 0.051081 | 0.008333 | 0.002985
0.855990 | 0.806820 | 0.647383 | 0.492539 | 0.213086 | 0.049443 | 0.008242 | 0.002952
0.840501 | 0.801888 | 0.664245 | 0.502773 | 0.228184 | 0.049544 | 0.008701 | 0.003083
0.837067 | 0.800934 | 0.646826 | 0.508861 | 0.221631 | 0.056800 | 0.008643 | 0.003001
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
