SamyFrancelet/LoRaSnow/0100_Research/0120_Prototypes/0121_OpenCV/snow_debit/logs/2021-11-12_152939/measure.csv

thr_100 | thr_120 | thr_140 | thr_160 | thr_180 | thr_200 | thr_220 | thr_240
0,427103 | 0,173324 | 0,000521 | 0 | 0 | 0 | 0 | 0
0,900749 | 0,765648 | 0,649593 | 0,450693 | 0,315107 | 0,154372 | 0 | 0
0,903008 | 0,759408 | 0,615257 | 0,405781 | 0,268512 | 0,116868 | 0 | 0
0,902096 | 0,760231 | 0,636191 | 0,419251 | 0,276846 | 0,116787 | 0 | 0
0,901943 | 0,761895 | 0,644437 | 0,455918 | 0,328008 | 0,166436 | 0,00001 | 0
0,896787 | 0,760794 | 0,648158 | 0,465615 | 0,335876 | 0,176423 | 0 | 0
0,898027 | 0,763151 | 0,641683 | 0,440885 | 0,308132 | 0,150944 | 0 | 0
0,895003 | 0,762982 | 0,648652 | 0,454701 | 0,320244 | 0,154056 | 0 | 0
0,896833 | 0,759971 | 0,639398 | 0,453288 | 0,315924 | 0,148991 | 0 | 0
0,90998 | 0,765996 | 0,644395 | 0,449515 | 0,312171 | 0,144958 | 0,000013 | 0
0,897243 | 0,758883 | 0,640088 | 0,454036 | 0,310671 | 0,140111 | 0 | 0
0,895814 | 0,760944 | 0,63612 | 0,451003 | 0,311657 | 0,139463 | 0 | 0
0,895596 | 0,76193 | 0,649287 | 0,451217 | 0,310586 | 0,140641 | 0 | 0
0,895146 | 0,761637 | 0,652158 | 0,453109 | 0,314827 | 0,143265 | 0 | 0
0,894678 | 0,761051 | 0,658864 | 0,472965 | 0,320775 | 0,145817 | 0 | 0
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
