SamyFrancelet/LoRaSnow/0000_Docs/0000_Report/LoRaSnow_report/Images/photos_PGA/TestBox.jpeg

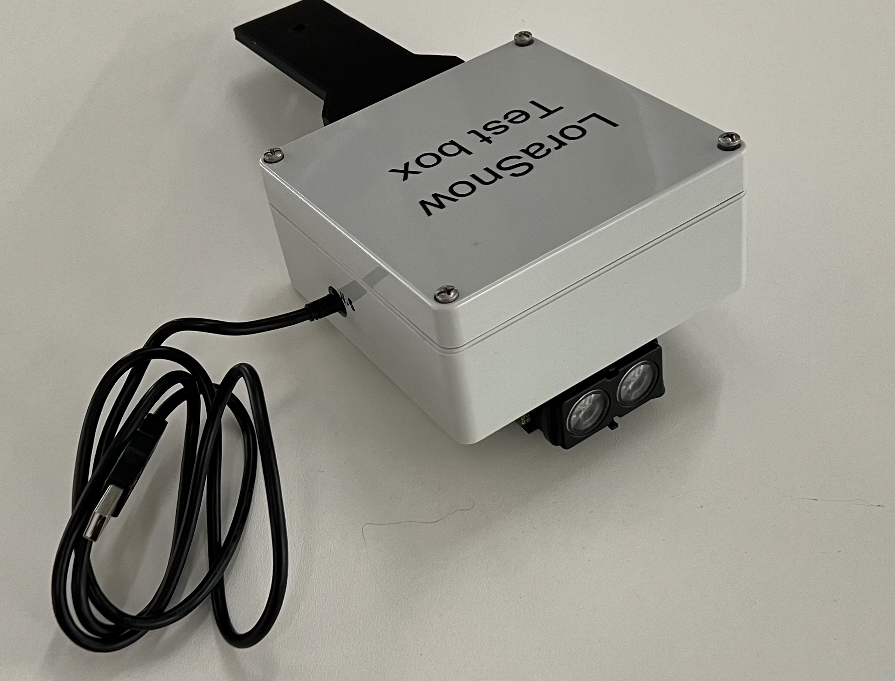
0000_Docs/0000_Report/LoRaSnow_report/Images/photos_PGA/TestBox.jpeg
