SamyFrancelet/LoRaSnow/0100_Research/0120_Prototypes/0121_OpenCV/tests/grayscale.jpg

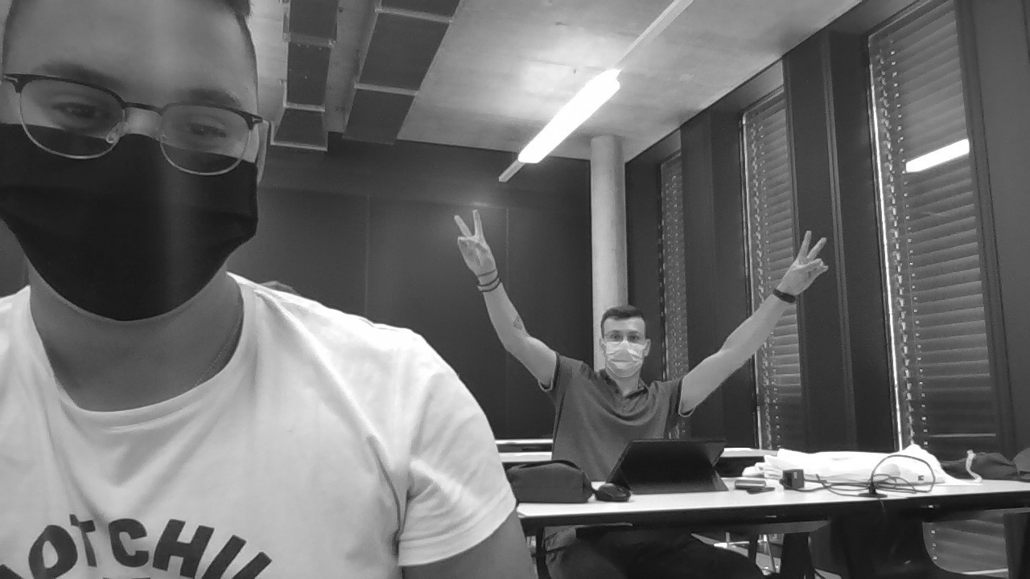
0100_Research/0120_Prototypes/0121_OpenCV/tests/grayscale.jpg
