SamyFrancelet/LoRaSnow/0100_Research/0120_Prototypes/0121_OpenCV/tests/image.jpg

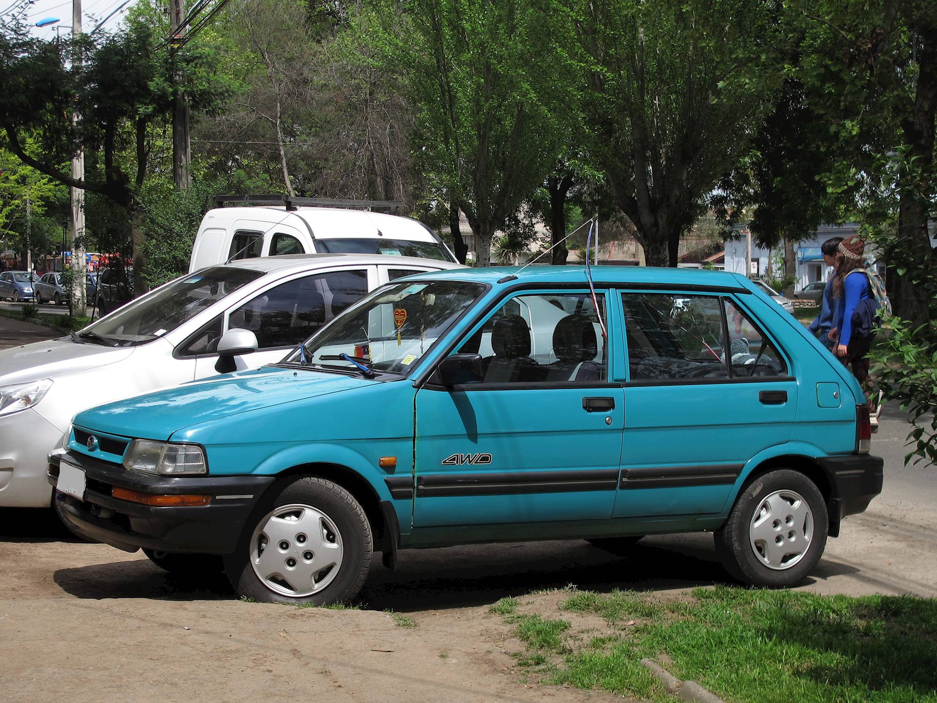
0100_Research/0120_Prototypes/0121_OpenCV/tests/image.jpg
