SamyFrancelet/LoRaSnow/0000_Docs/0000_Report/LoRaSnow_report/Docs/misesenplansmergez.pdf

1404

2000 1596

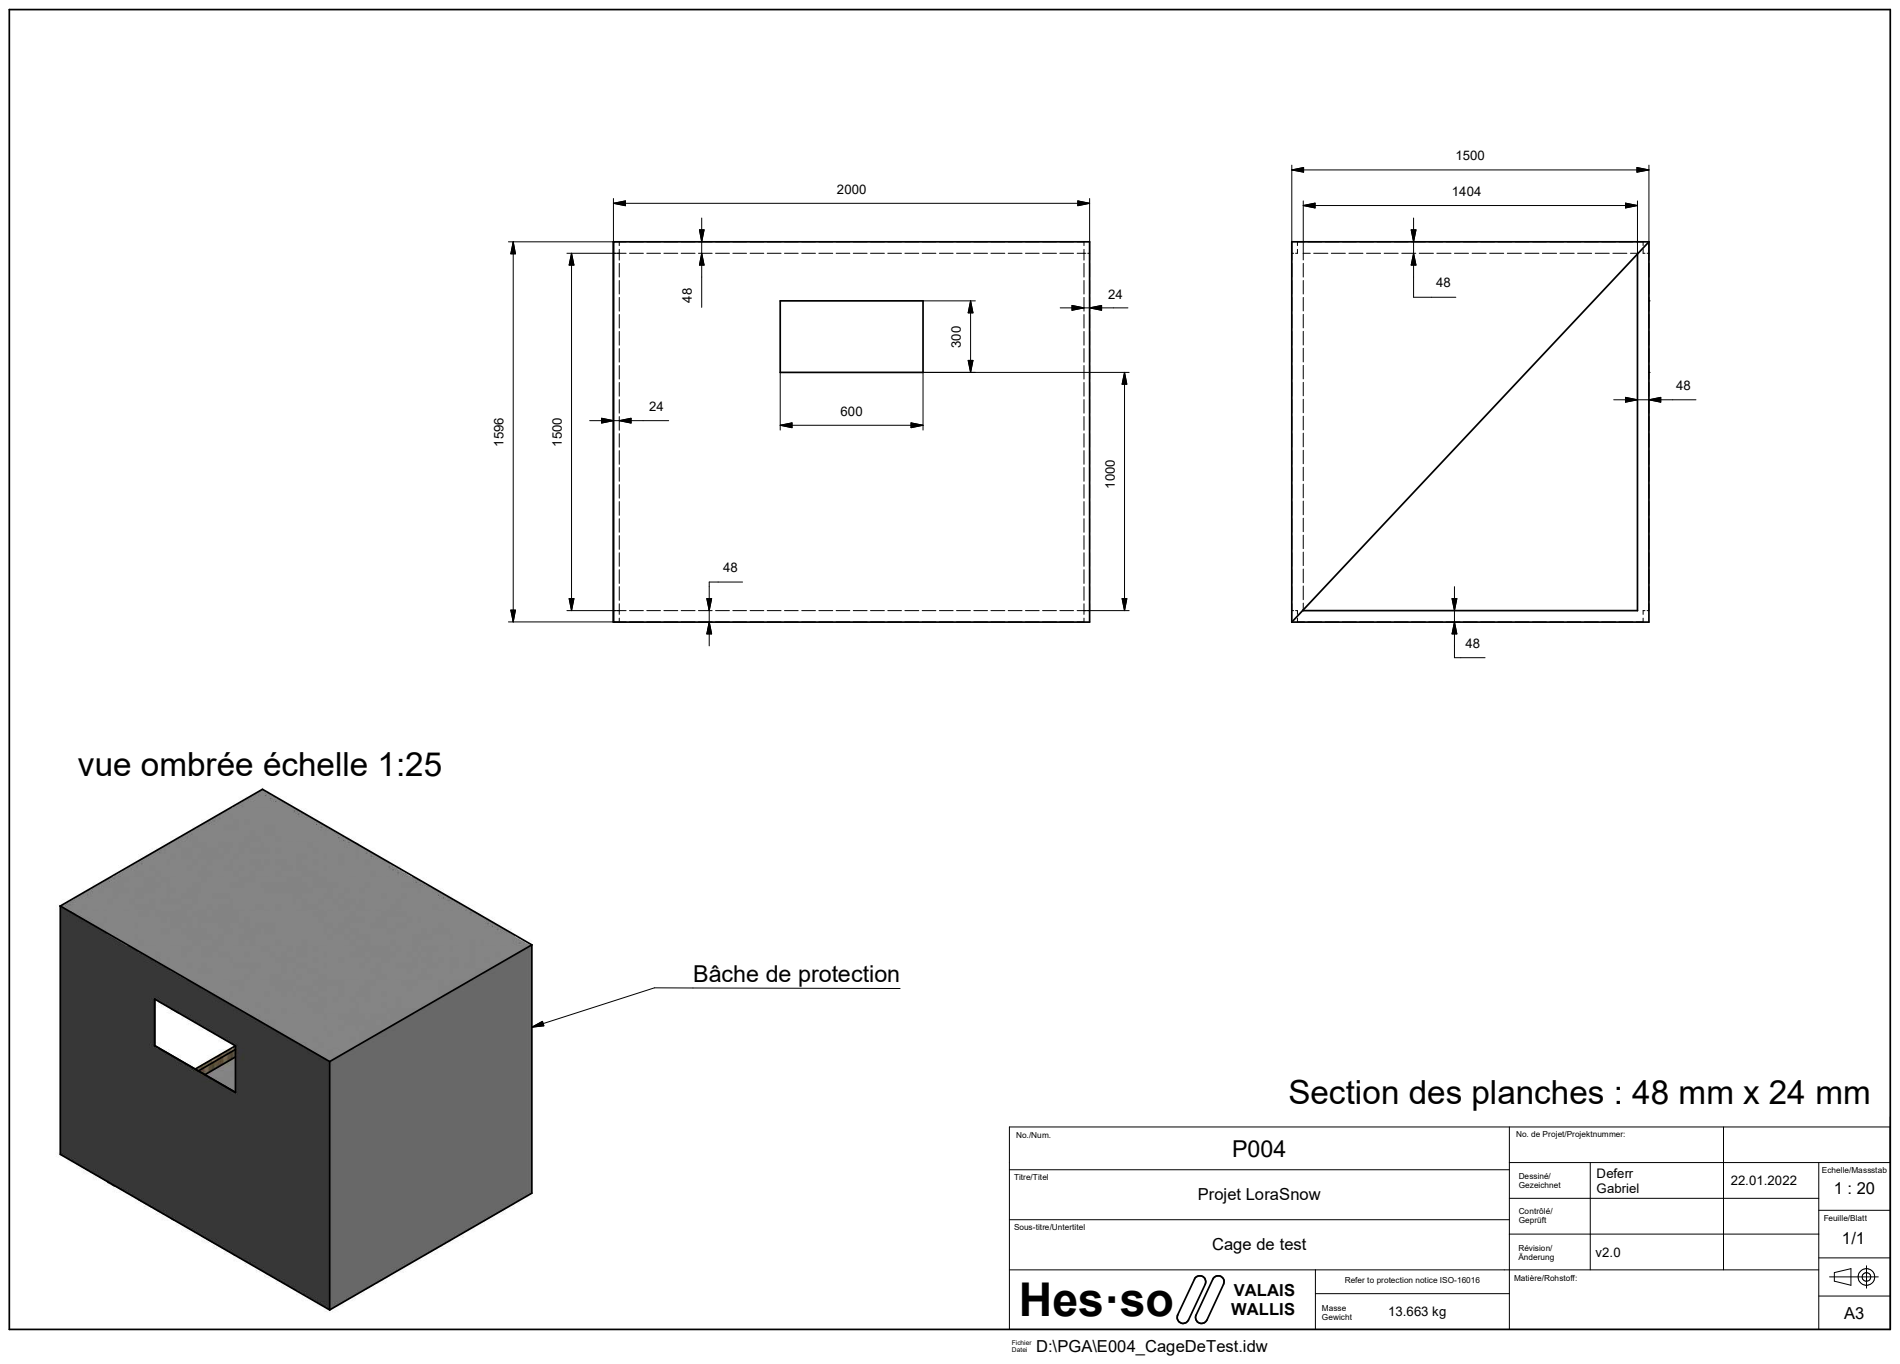
[picture p217: page 1]
Projet LoraSnow; Titre/Titel; Feuille/Blatt; vue ombrée échelle 1:25

Section des planches : 48 mm x 24 mm ¹⁰⁰⁰

Bâche de protection

No./Num. P004 | No. de Projet/Projektnummer:

Dessiné/ Gezeichnet | Deferr Gabriel | 22.01.2022 | Echelle/Massstab 1 : 20

Contrôlé/ Geprüft

Sous-titre/Untertitel

Cage de test

Änderung | v2.0 Révision/

Hes·so VALAIS WALLIS | Refer to protection notice ISO-16016 | Matière/Rohstoff:

Masse 13.663 kg Gewicht | | A3

Datei D:\PGA\E004_CageDeTest.idw
Fichier

150 | 50 | 80

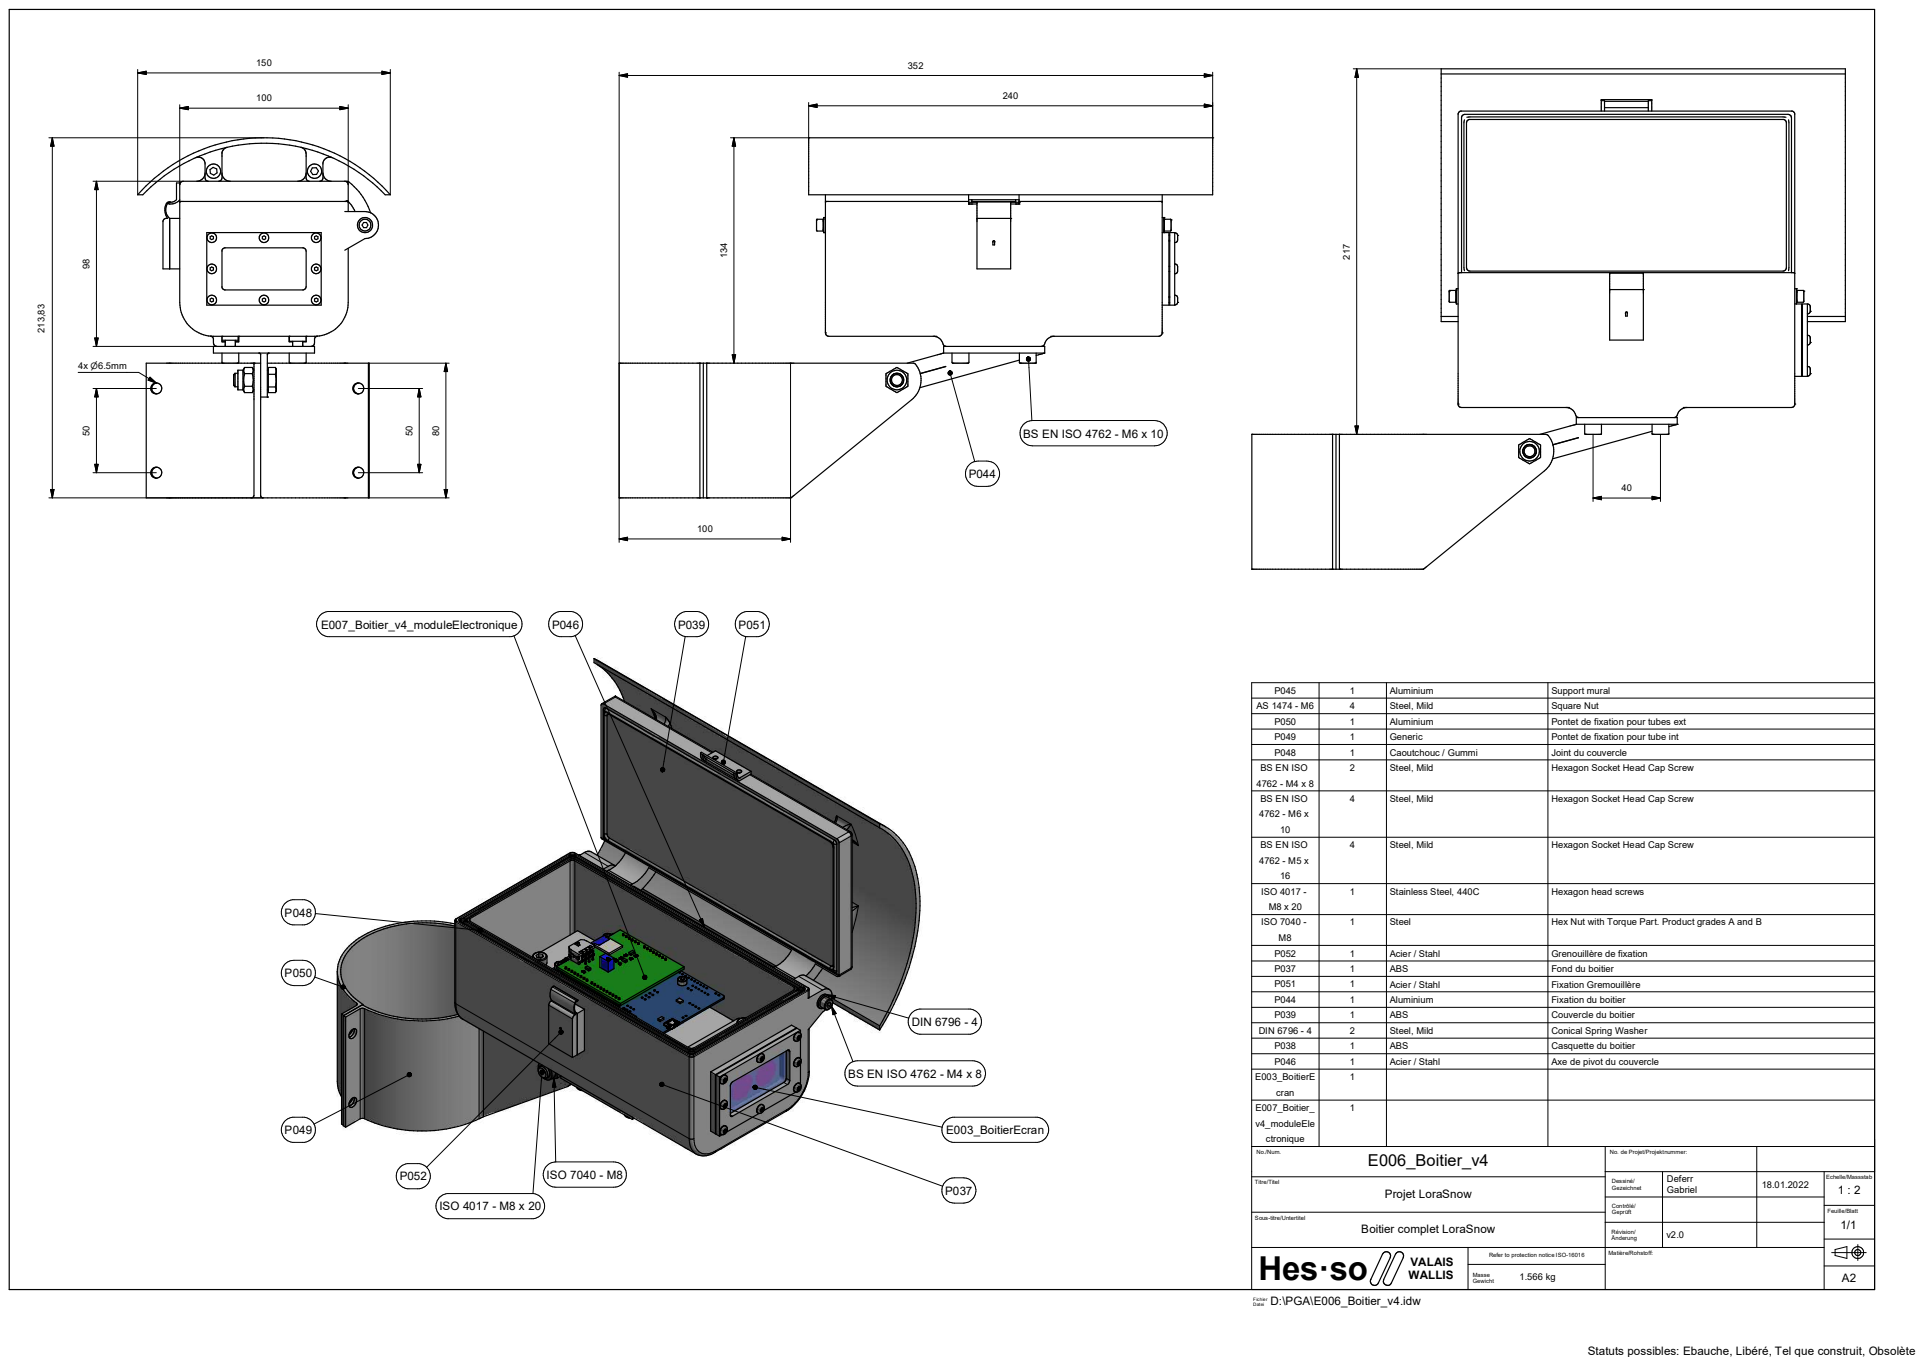
[picture p218: page 2]

No. de Projet/Projektnummer:

Statuts possibles: Ebauche, Libéré, Tel que construit, Obsolète

194,4 | 80

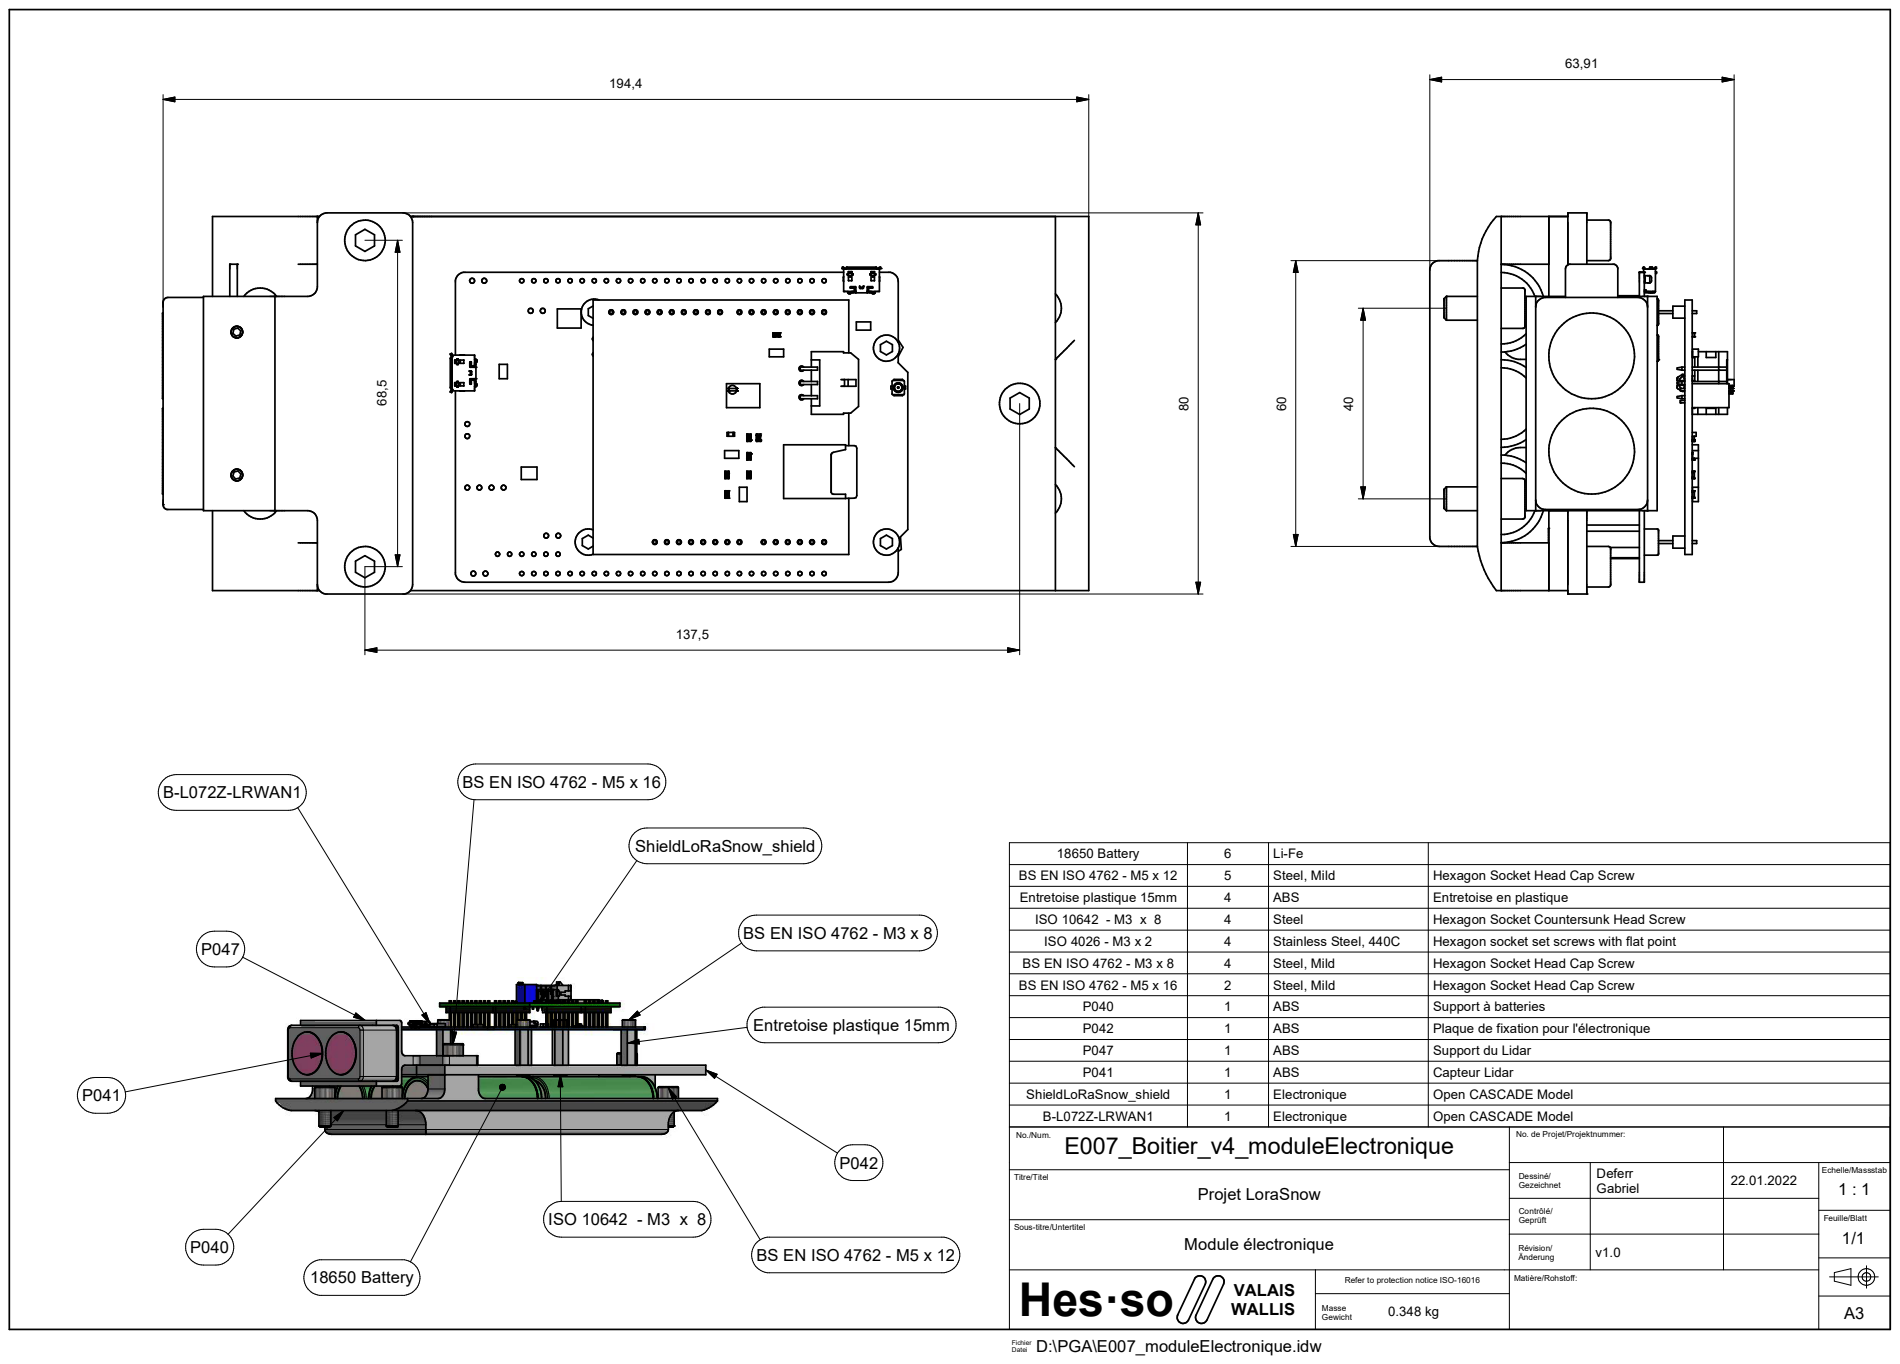
[picture p219: page 3]
Projet LoraSnow; Module électronique; Dessiné/ Gezeichnet; Contrôlé/ Geprüft; Deferr; Gabriel; Echelle/Massstab 1 : 1; E007_Boitier_v4_moduleElectronique No./Num.; Titre/Titel; v1.0 Révision/; Feuille/Blatt; 18650 Battery; BS EN ISO 4762 - M5 x 12; Steel, Mild; Hexagon Socket Head Cap Screw; Entretoise plastique 15mm; ABS; Entretoise en plastique; ISO 10642 - M3 x 8; Steel; Hexagon Socket Countersunk Head Screw; ISO 4026 - M3 x 2; Stainless Steel, 440C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

BS EN ISO 4762 - M5 x 16

BS EN ISO 4762 - M3 x 8

No. de Projet/Projektnummer:

Sous-titre/Untertitel

BS EN ISO 4762 - M5 x 12

Datei D:\PGA\E007_moduleElectronique.idw
