SamyFrancelet/LoRaSnow/0000_Docs/0000_Report/LoRaSnow_report/Docs/schema.pdf

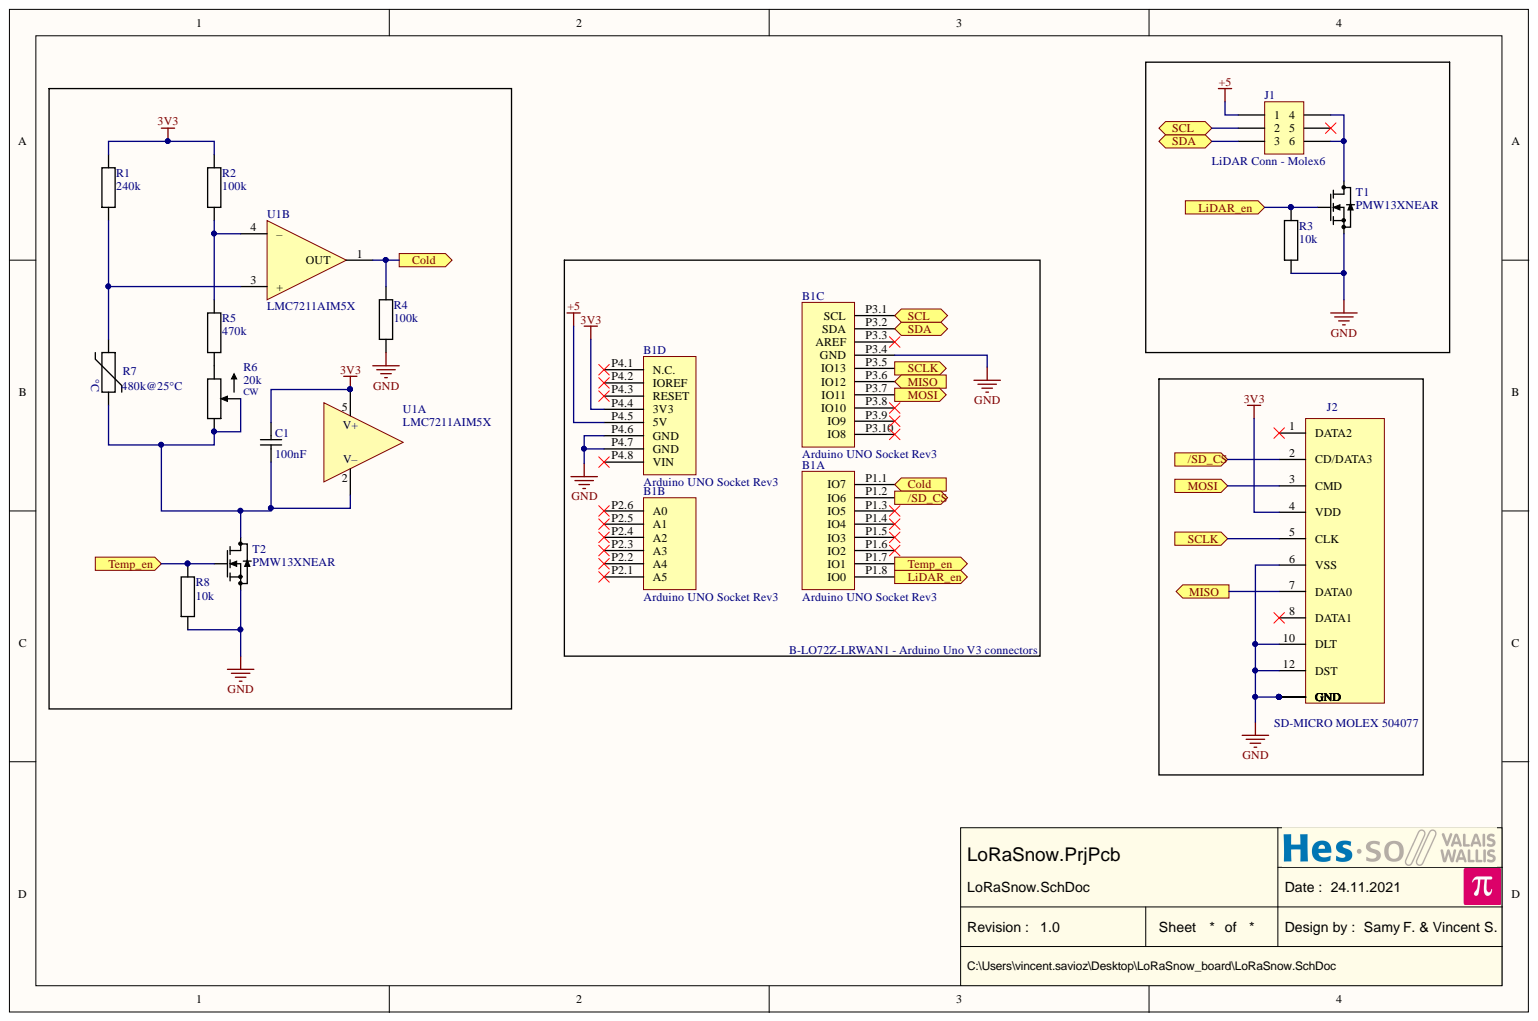
[picture p220: page 1]

LoRaSnow.PrjPc b LoRaSnow.SchDoc

Revision : 1.0 | Sheet * of * | Design by : Samy F. & Vincent S .

# Board Stack Report
