SamyFrancelet/LoRaSnow/0000_Docs/0004_Business/best.pdf

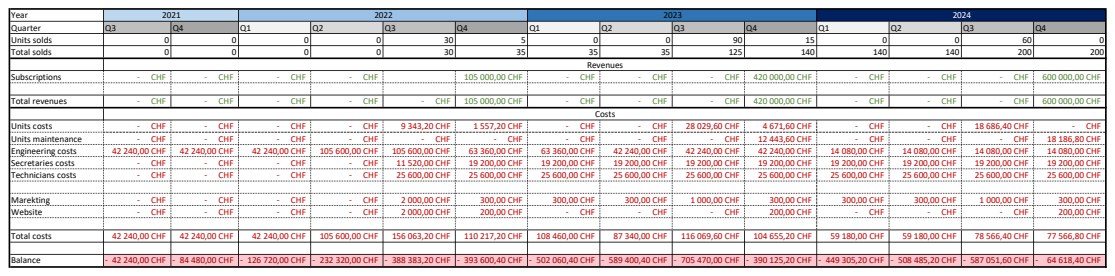
[picture p222: page 1]
Year; Quarter; Units solds; Total solds; Subscriptions; - CHF - CHF; - CHF; 105 000,00 CHF; 420 000,00 CHF; 600 000,00 CHF; Total revenues; Units costs; 9 343,20 CHF; 1 557,20 CHF; 28 029,60 CHF; 4 671,60 CHF; 18 686,40 CHF; Units maintenance; 12 443,60 CHF; 18 186,80 CHF; Engineering costs; 42 240,00 CHF 42 240,00 CHF; 42 240,00 CHF; 105 600,00 CHF; 63 360,00 CHF; 14 080,00 CHF; Secretaries costs; 11 520,00 CHF; 19 200,00 CHF; Technicians costs; 25 600,00 CHF; Marekting; 2 000,00 CHF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
