SamyFrancelet/LoRaSnow/0100_Research/0130_Simulations/Draft1.asc

A1: dflop; Vlow=-2.5 Vhigh=2.5
U1: sub
U2: integ; G=5e5
U3: UniversalOpamp2; Avol=100Meg GBW=10G Slew=10G
U4: laplace_2nd_order; n0=2.5266e9 n1=0 n2=0; d0=2.5266e9 d1=7.1086e4 d2=1
V1: voltage; PULSE(0 5 1e-6 1e-9 1e-9 0.5e-6 1e-6)
V2: voltage; 2.5
V3: voltage; 2.5
V4: voltage; SINE(0 2 1000)
Named nets: 0, -2.5V, +2.5V, Vin, clk, Vout, Vff
