SamyFrancelet/LoRaSnow/0100_Research/0130_Simulations/NTC_Dev.asc

R1: res; 240k
R3: res; 82k
R4: res; 482k
R5: res; 100k
RNTC: res; {NTC}
U1: UniversalOpamp2
V1: voltage; 5
Named nets: 0, 5V
.tran 10m
.step param NTC 480k 2Meg 50k
