SamyFrancelet/LoRaSnow/(list of files, drawings)

Other design files:
0200_Hardware/B-L072Z-LRWAN1/MB1296-Connectors.SchDoc
0200_Hardware/B-L072Z-LRWAN1/MB1296-LRA_Module.SchDoc
0200_Hardware/B-L072Z-LRWAN1/MB1296-Power.SchDoc
0200_Hardware/B-L072Z-LRWAN1/MB1296-STLINK.SchDoc
0200_Hardware/B-L072Z-LRWAN1/MB1296-STM32_LRA_Disco.PrjPcb
0200_Hardware/B-L072Z-LRWAN1/MB1296-STM32_LRA_Disco_revD1.PcbDoc
0200_Hardware/B-L072Z-LRWAN1/MB1296-Top.SchDoc
0200_Hardware/B-L072Z-LRWAN1/MB1296-USB_Antenna.SchDoc
0200_Hardware/LoRaSnow_shield/LBAA0QB1SJ-296/LBAA0QB1SJ-296.SchLib
0200_Hardware/LoRaSnow_shield/LBAA0QB1SJ-296/MODULE_LBAA0QB1SJ-296.PcbLib
0200_Hardware/LoRaSnow_shield/LoRaSnow.PcbDoc
0200_Hardware/LoRaSnow_shield/LoRaSnow.PrjPcb
0200_Hardware/LoRaSnow_shield/LoRaSnow.SchDoc
0200_Hardware/LoRaSnow_shield/LoRaSnow_big.SchDoc
0200_Hardware/LoRaSnow_shield/LoRaSnow_lib.PcbLib
0200_Hardware/LoRaSnow_shield/LoRaSnow_lib.SchLib
0200_Hardware/LoRaSnow_shield/LoRaSnow_smol.SchDoc
0200_Hardware/LoRaSnow_shield/NUCLEO-F767ZI/SnapEDApcb.PcbLib
0200_Hardware/LoRaSnow_shield/NUCLEO-F767ZI/SnapEDAsch.SchLib
