SamyFrancelet/LoRaSnow/0100_Research/0120_Prototypes/0122_LiDarLitev4/Discovery/LoRaSnow_GarminLidarLiteV4/Core/Src/main.c

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
/* Includes ------------------------------------------------------------------*/
#include "main.h"

/* USER CODE BEGIN Includes */

#include <stdbool.h>
#include <string.h>
#include <stdio.h>
#include <math.h>

#include "../Sensors/Inc/LIDARLite_v4LED.h"
#include "../Sensors/Inc/LIDAR_functions.h"

/* USER CODE END Includes */

I2C_HandleTypeDef hi2c1;

UART_HandleTypeDef huart2;

void SystemClock_Config(void);
static void MX_GPIO_Init(void);
static void MX_USART2_UART_Init(void);
static void MX_I2C1_Init(void);
/**
  * @brief  The application entry point.
  * @retval int
  */
int main(void)
{
  /* USER CODE BEGIN 1 */

	//Variables
	LIDARLite_TypeDef lidar;						//Our LIDAR
	float lidarAngle = 45, roadAngle = 0;		//Lidar angle from vertical and road angle from plane in degrees

  /* USER CODE END 1 */

  /* MCU Configuration--------------------------------------------------------*/

  /* Reset of all peripherals, Initializes the Flash interface and the Systick. */
  HAL_Init();

  /* Configure the system clock */
  SystemClock_Config();

  /* Initialize all configured peripherals */
  MX_GPIO_Init();
  MX_USART2_UART_Init();
  MX_I2C1_Init();
  /* Infinite loop */
  /* USER CODE BEGIN WHILE */

  //Convert angle from deg to rad
  lidarAngle *= M_PI/180;
  roadAngle *= M_PI/180;

  //Enable temperature and LIDAR
  HAL_GPIO_WritePin(LIDAR_en_GPIO_Port, LIDAR_en_Pin, GPIO_PIN_SET);
  //HAL_GPIO_WritePin(TEMP_en_GPIO_Port, TEMP_en_Pin, GPIO_PIN_SET); //Todo resolder pin

  LIDARfc_init(&huart2, &lidar, &hi2c1, lidarAngle, roadAngle);  //Init LIDAR connection

  //Take reference distance to ground (no snow)
  LIDARfc_saveRefDistance();

  bool stay = true;

  while (1)
  {
	  while(stay)
	  {
		  HAL_StatusTypeDef ret = HAL_UART_Receive(&huart2, str, 1, HAL_MAX_DELAY);
		  if(ret == HAL_OK)
		  {
			  stay = false;
		  }
	  }

	  stay = true;

	  /*if(/*!HAL_GPIO_ReadPin(GPIOC, GPIO_PIN_13))	//User button to start measurement
	  {*/
		  LIDARfc_measureOffset();
	  //}

		  //HAL_Delay(30000);

    /* USER CODE END WHILE */

    /* USER CODE BEGIN 3 */
  }
  /* USER CODE END 3 */
}

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
