SamyFrancelet/LoRaSnow/0100_Research/0120_Prototypes/0122_LiDarLitev4/ArduinoTests/GetDistance/GetDistance.ino

/******************************************************************************
  Reads the distance something is in front of LIDAR and prints it to the Serial port

  Priyanka Makin @ SparkX Labs
  Original Creation Date: Sept 30, 2019

  This code is Lemonadeware; if you see me (or any other SparkFun employee) at the
  local, and you've found our code helpful, please buy us a round!

  Hardware Connections:
  Plug Qwiic LIDAR into Qwiic RedBoard using Qwiic cable.
  Set serial monitor to 115200 baud.

  Distributed as-is; no warranty is given.
******************************************************************************/
#include "LIDARLite_v4LED.h"

LIDARLite_v4LED myLIDAR; //Click here to get the library: http://librarymanager/All#SparkFun_LIDARLitev4 by SparkFun

void setup() {
  Serial.begin(115200);
  Serial.println("Qwiic LIDARLite_v4 examples");
  Wire.begin(); //Join I2C bus

  //check if LIDAR will acknowledge over I2C
  if (myLIDAR.begin(0x62, Wire) == false) {
    Serial.println("Device did not acknowledge! Freezing.");
    while(1);
  }
  Serial.println("LIDAR acknowledged!");
}

void loop() {
  float newDistance;

  //getDistance() returns the distance reading in cm
  newDistance = myLIDAR.getDistance() - 8.00;

  //Print to Serial port
  Serial.print("New distance: ");
  Serial.print(newDistance);
  Serial.println(" cm");

  delay(20);  //Don't hammer too hard on the I2C bus
}
