SamyFrancelet/LoRaSnow/(commit log)

2021-10-01 Added basefolders
    [BoM.ods]
2021-10-06 Small Structure change + LiDar Arduino Code
2021-10-08 Test Protocol + STM32 Project
    [TestProtocolTemplate.xlsx]
2021-10-15 LIDARLite implementation on STM32-DISCO
2021-10-20 Draw LIDAR error charateristic
    [Error Characteristics.xlsx, TestProtocolTemplate.xlsx, TestProtocol_LIDARLitev4.xlsx]
2021-10-29 Tested csv output + added turbine file
    [eggs.csv]
2021-11-12 ready to test openCV
    [eggs.csv, measure.csv]
2021-11-12 updated gitignore
    [measure.csv]
2021-11-12 first meas
    [measure.csv]
2021-11-16 LiDar measurements and analysis
    [211022_ErrorMesTest.xlsx, 211022_TempStabilityTest.xlsx, 21116_OffsetMeasures.xlsx, TestProtocol_LIDARLitev4.xlsx]
2021-11-24 Offset measurements tests
    [211022_ErrorMesTest.xlsx, 21116_OffsetMeasures.xlsx, TestProtocol_LIDARLitev4.xlsx]
2021-11-26 added powershell script to get videos from Ayent
    [measure.csv]
2021-12-02 Ajout mécanique + power point
    [01621_01-2-016210-01-0.0002.ipt, 01621_01-2-016210-01-0.ipt, 02062_Bearbeitung n. Zeichn. (01-2-021510-03-0).ipt, 93134.ipt, 99999_1040_Fr Deckel 02062.ipt, ALU-TP-158 Extended.STEP, ALU-TP-158 Retracted.STEP, Boitier_Phoenix_A150.0003.iam]
2021-12-02 PCB + Business
    Added budget draft, moved Presentation to Docs.
    Added Schematic + PCB of LoRaSnow shield
    [Budget.xlsx, LBAA0QB1SJ-296.SchLib, LoRaSnow.PcbDoc, LoRaSnow.PrjPcb, LoRaSnow.SchDoc, LoRaSnow_big.SchDoc, LoRaSnow_lib.PcbLib, LoRaSnow_lib.SchLib]
2021-12-10 Modif du budget
    [Budget.xlsx]
2021-12-10 Snowy measures
    [RealTestResults.xlsx, TestProtocol_LIDARLitev4.xlsx]
2021-12-10 Added business report
    [Budget.xlsx]
2021-12-15 Ajout de la présentation de gestion
    [211022_ErrorMesTest.xlsx, 211022_TempStabilityTest.xlsx, Error Characteristics.xlsx]
2021-12-17 Updated snow_debit detection
    [measure.csv]
2021-12-17 Added step file and removed heavy files
    Added step file of the LoRaSnow shield
    and removed heavy pptx, excel and video files
    [Budget.xlsx, LoRaSnow.PrjPcb, LoRaSnow_shield.step]
2021-12-17 Added B-L072Z-LRWAN1 CAD files and 3D step
    [B-L072Z-LRWAN1.step, MB1296-Connectors.SchDoc, MB1296-LRA_Module.SchDoc, MB1296-Power.SchDoc, MB1296-STLINK.SchDoc, MB1296-STM32_LRA_Disco.PrjPcb, MB1296-STM32_LRA_Disco_revD1.PcbDoc, MB1296-Top.SchDoc]
2022-01-14 mec update
    [99999_1040_Fr Deckel 02062.ipt, E003_BoitierEcran.0007.iam, E003_BoitierEcran.0009.iam, E003_BoitierEcran.iam, E005_Boitier_v3.0004.iam, E005_Boitier_v3.0007.iam, E005_Boitier_v3.iam, E006_Boitier_v4.0014.iam]
2022-01-17 Snow detection
    Implemented snow on road and snowfall detection with noise cancelling and background isolation
    [measure.csv]
2022-01-17 update final Inventor
    [01621_01-2-016210-01-0.ipt, 02062_Bearbeitung n. Zeichn. (01-2-021510-03-0).ipt, 1050170001.iam, 18650 Battery.ipt, 6688609584.iam, 6688609984.iam, 6688610624.iam, 6688610944.iam]
2022-01-20 updated snow measurements
    [measure.csv]
2022-01-20 Added Report folder and updated Video Getter powershell scripts
2022-01-20 Report Transfer
    [99999_1040_F_r Deckel 02062.ipt, RealTestResults.xlsx, Rentabilité.xlsx]
2022-01-20 Début des problèmes
    Les références fonctionnent enfin.
    Reste a décider de comment on structure ces références
2022-01-22 Updated budget
    [Budget.xlsx]
2022-01-22 LiDar Synthèse
2022-01-23 Paf
    Chocapic
    [Budget.xlsx]
2022-01-23 Mechanical report fully finished and controlled
    [Risques.xlsx, analyse.xlsx, measure.csv, snowOnRoad.csv, snowfall.csv]
2022-01-23 Added LiDAR synthesis
2022-01-23 PCB part updated
2022-01-23 Added computer vision results picture, will finish text after business
    I just hit my head against a wall for 2 hours because of the fucking \headheight warning!!!!!!!!!
    Updated size to 15
    [Risques.xlsx, analyse.xlsx, snowOnRoad.csv, snowOnRoad_denoise.csv, snowOnRoad_noise.csv, snowfall.csv]
2022-01-23 Planning updated
    [PlanningPrevu.xlsx]
2022-01-23 business report finished (i think, i hope)
    [Budget.xlsx, PlanningPrevu.xlsx]
2022-01-24 bordel je vois plus le bout de s't'histoire
2022-05-05 update report
    [analyseBis.xlsx]
